JacobBanghart/clickdeck/hardware/driver-bench/netlist.txt

# driver-bench netlist (generated by gen_pcb.py; UNTESTED)

3V3: J1.7 R6.2 R7.2
AVDD1: C5.1 C6.1 U1.17 U1.2 U1.22 U1.23
CP1: C4.1 U1.6
EN1: J1.5 R5.1 U1.18 U1.19 U1.20 U1.24
EN2: J1.9 R8.1 U2.1 U2.2 U2.24 U2.3
FLT1: J1.6 R6.1 U1.1
FLT2: J1.8 R7.1 U2.20
GND: C1.2 C11.2 C12.2 C2.2 C3.2 C5.2 C6.2 C7.2 C8.2 C9.2 J1.1 J1.10 J4.2 R2.2 R3.2 R4.2 R5.2 R8.2 U1.16 U1.21 U1.25 U1.9 U2.12 U2.15 U2.25 U2.8
OUT1A: J2.1 U1.10
OUT1B: J2.2 U1.11
OUT1C: J2.3 U1.12
OUT2A: J3.3 U2.9
OUT2B: J3.2 U2.10
OUT2C: J3.1 U2.11
PWM_A: J1.2 R2.1 U1.15 U2.4
PWM_B: J1.3 R3.1 U1.14 U2.5
PWM_C: J1.4 R4.1 U1.13 U2.6
V3P3_2: C11.1 U2.18
VCP2: C10.1 U2.14
VM: C1.1 C10.2 C12.1 C2.1 C3.1 C4.2 C7.1 C8.1 C9.1 J4.1 U1.7 U1.8 U2.13 U2.16 U2.7

Not connected: U1.3 U1.4 U1.5 (SOC, SOB, SOA: current-sense outputs, unused), U2.17 U2.19 U2.21 U2.22 U2.23 (NC)
