JacobBanghart/clickdeck/docs/plan.md

# Plan

## Goals

**Final device**
- At least 20 keys, each showing its own image under a clear cap.
- Keys use **micro switches** (mouse/controller-style click), not rubber domes.
- At least 5 knobs, each with a display area right next to it.
- Knobs: **clicky vs. smooth switchable in software** (hard requirement).
  Adjustable detent count/strength and end stops are nice-to-have.
  Full force feedback is not required.
- **USB only.** Must not show up as a monitor.
- **Works standalone:** set up once in a web configurator, everything
  stored on the device. Optional host software for live integrations
  (Linux first).
- Knobs also **press to click**, like Stream Deck dials.
- An optional **touch band** under the knob displays for taps and swipes
  (an add-on, off by default since D24).
- Simple to build: case printable at home (256 mm bed), one JLC order.
  Cost isn't a design driver (a single build costs more than a Stream
  Deck + XL; [cost.md](cost.md)), but the numbers stay honest.
- **Cost target (owner, locked 2026-10-19, D24):** the full version
  (5 haptic knobs, 21 keys, display) at **$250 retail at 100 units**, plus
  shipping and taxes. Easy cuts applied: the DRV8311H driver, the touch
  band off by default, and for a 100-unit run factory-direct motors,
  owner-printed resin caps and bulk cables and hardware. At 100 units it
  comes out at ~$165–215 per device before one-time costs, so $250 holds
  near zero margin only if the one-time costs aren't spread over those 100
  ([cost.md](cost.md), "Path to $250").

**Explicitly not wanted**
- Hall-effect switches.
- Huge SmartKnob-sized knobs; aim for something closer to the MX Master
  MagSpeed wheel in size.

**Design constraints (owner, locked 2026-10-18; design review D8, D19–D21)**
- **Keys travel straight.** Caps move straight up and down, guided by the
  plate. No pivots, hinges or rockers on the keys, in this or any future
  revision. The knob press hinge (D10) is separate and not affected.
- **One shared display.** All key images and knob display areas come from
  the single shared LCD (Waveshare 7B). No separate small screens per key,
  and no screen inside or on top of a knob. The knob display areas stay
  above the knobs on the shared panel (`KNOB_WIN` in `cad/params.py`). More
  keys would need a bigger single panel, not more screens.
- **Core haptics first.** The knob feel is the focus: clicky detents,
  smooth, a set number of clicks, end stops, a tick at a preset. Attention
  nudges and haptic notifications are an optional firmware feature, off by
  default, in a separate module so a build can leave it out.
- **Its own look.** The face shape, stand, key and knob styling and
  branding stay clickdeck's own. Comparisons with the Stream Deck + XL are
  fine; the case and stand aren't modeled to look like it.

**Knobs are modules in slots (owner, locked 2026-10-19; D23, with D22)**
- The case keeps five knob positions as **slots**. Each takes a **haptic
  module** (motor, driver, sensor, press switch: software clicky and
  smooth), a **lite module** (an EC11-size push encoder, detented or smooth
  as ordered, D22) or a **blank** cover, flush with the plate.
- The first build has two haptic modules and three blanks; knobs get added
  later. Swap from the top with the case closed: pull the cap, undo two
  screws, lift the module out, drop the new one in. Unplug USB first (no
  hot-plugging).
- The old knob board becomes the **backplane**: RP2350B, connectors and one
  slot connector (18 pogo pins) per slot. Modules have no MCU; one firmware
  reads each slot's type at power-up, and the configurator shows haptic
  settings only for haptic slots and hides empty ones.
- Both module types put the knob top where the haptic knob was, checked by
  `cad/assembly.py --check` with every slot haptic, every slot lite and the
  default build. Modules: [knob-module.md](knob-module.md); pinout:
  [wiring.md](wiring.md); costs (base + per module): [cost.md](cost.md);
  parts: [bom.md](bom.md).

## Architecture

```
 PC: web configurator (browser, setup) · optional daemon (live integrations) · or nothing
   │  single USB-C cable, into the back wall
   ▼
 USB board: USB 2.0 hub (CH334F), reads the port's current offer (CC pins)
   ├── USB ──► backplane: RP2350B (USB device 1)
   │             ├── USB HID (keyboard + media) + WebUSB data channel → keymap, macros, knob settings
   │             ├── optional 1-wire link ──► display board GPIO6 (page, wake)
   │             ├── 5 knob slots (pogo pins): haptic module (MT6701 + driver + press switch),
   │             │     lite module (push encoder) or blank
   │             ├── 21-key matrix (frame PCB, switches only)
   │             └┄┄ I²C ┄┄► touch band (optional add-on, under the top plate)
   └── USB ──► ESP32-S3 + 7" display board (USB device 2; bought: Waveshare ESP32-S3-LCD-7B, 1024×600)
                 ├── WebUSB data channel → pages, images, display settings (~0.5 MB/s)
                 └── drives the LCD   → all key images + knob display areas
```

The host sees two USB devices behind a hub; the software pairs them
([protocol.md](protocol.md)). Inside the case every link is a bought cable
plugged into a connector JLC fits: no soldering or crimping
([wiring.md](wiring.md)).

### Software: web configurator, optional daemon
VIA-style: a **web configurator** (a static page using WebUSB, WebHID and
Web Serial; Chromium browsers only) is the main tool. It sets the key
layout and pages, HID shortcuts and macros, knob feel, images and
brightness, and updates the firmware of both chips. Everything is stored
on the device, so clickdeck works on any computer with no software
installed.

A small optional **host daemon** (`clickdeckd`) adds live integrations:
changing images, showing app state (mic muted, volume), running scripts.
OpenDeck or Companion Satellite thin clients are possible later, on top of
it. Details: [configurator.md](configurator.md).

Linux needs a udev rule (`uaccess`) so the browser can open the devices.

### Why a bulk channel for images
HID on full-speed USB is limited to ~64 KB/s (64-byte reports, one 120×120
key image ≈ 0.5 s), so WebHID is too slow. Each chip has a vendor bulk
interface that the browser reaches through WebUSB. Plan on about 0.5 MB/s
(Espressif's figure for its USB stack): one raw key takes ~85 ms, a raw
full page ~1.8 s. So RLE/JPEG is the default, not an option. Also: upload
icons once and reference them by CRC; redraw only the parts of the screen
that changed. Target: a full page in under 300 ms.

### Keys: images under clear caps
One LCD panel under a **frame-shaped PCB** (square window cut out per key).
A clear resin cap sits in each window; a tab on the cap presses a micro
switch mounted on the PCB strip between windows.

The frame PCB must not rest on the glass, and the glass must not be the
cap's stop (design review B1–B3, decision D8):
- **More frame support:** 14 M2 screws hold the frame PCB: 5 pan-head
  along the back and left edges (off the glass) and 9 countersunk, flush
  with the PCB's underside, over the glass (4 between the knob windows, 3
  on the right margin, 2 at strip crossings x = ±33 mm between key rows 2
  and 3).
- **Cap down-stop:** caps and frame PCB sit 0.8 mm above the glass
  (`GLASS_GAP`; the image sits ~0.6 mm deeper than with the old 0.2 mm).
  Rails under each cap's side lips and lugs at its back corners stop on the
  frame PCB after 0.5 mm of travel, past the B3U's worst-case 0.35 mm. 0.1
  and 0.2 mm shim washers tune the stack. `cad/keystack.py` checks that the
  worst cap drop (0.51 mm, with the guide below) plus the frame's flex (0.046 mm/N worst, down
  from 4.2 mm/N) leaves at least 0.1 mm to the glass at a 3 N press.
- **Cap guide (B3):** caps move straight up and down, guided by the plate.
  The plate's key hole continues down as a skirt around each cap, cut away
  where the lips, tab, lugs and switches pass, to 0.2 mm above the frame
  PCB. The fit is 0.05 mm per side (printed PETG plate, SLA caps). Tune it
  with the fit coupon via `HOLE_COMP`. Over 5.1 mm this lets the cap tilt up
  to 1.17°. That tilt is guide slop, not a feature. The down-stop keeps the
  cap off the glass: worst drop 0.51 mm, 0.29 mm to spare. `assembly.py
  --check` fails if that margin is under 0.1 mm, if a stop foot misses the
  PCB, or if a skirt side is missing. If off-center presses don't click
  cleanly on the prototype, use SLA resin guide inserts (~0.6°) or the
  second switch.
- **Second switch:** the prototype frame PCB has a second switch footprint
  per key. The off-center click test decides whether the full build needs two
  switches per key.

Laser-cut acrylic caps are out:
sheet tolerance alone is larger than the key stack's budget. The cap has
0.2 mm of vertical free play; an optional foam or silicone ring on the flange stops
rattle. Caps come in one standard clear finish for now; revisit the look
once real caps are in hand.

```
      ┌──────────────┐  ← clear cap (the image shows through it)
   ┌──┤              ├──┐  ← tab reaches past the window edge
 ══╧══╧══            ══╧══  ← PCB with a window cut out per key
  [sw]                      ← micro switch under the tab
 ───────────────────────────  ← one LCD panel
```

Knobs sit just past the panel edge; each knob's "display" is an area of
the same panel. There are no other screens (D19).

Full build target: Waveshare **ESP32-S3-LCD-7B** (non-touch, SKU 31727,
$33.99), 7" 1024×600 RGB panel with **adjustable backlight**. Chosen over
the original ESP32-S3-LCD-7 (800×480): same price and pinout, but the
original's backlight is on/off only (CH422G expander pin) without a wire
mod. Layout (from the CAD model): **7×3 = 21 keys at 22 mm pitch** (146 px
pitch; about 120×120 px visible under each cap) plus a ~20 mm strip below the keys for the 5 knob displays.
(5×4 at 30 mm doesn't fit: the panel's active area is only ~86 mm tall.)

The display board only draws the screen; it needs none of its free pins.
Keys, knobs and touch go to the RP2350B, which has its own USB connection
through the hub. 1024×600 is more work for the ESP32-S3 than 800×480; fine
for mostly static key images, but test full-screen redraw speed early.

Switches: **Omron B3U-1000P** (3.0 × 2.5 mm SMD tactile). The strip
between keys is 3.6 mm, so 13 mm mouse switches don't fit.

### Knobs
Small brushless gimbal motor + magnetic angle sensor + low-voltage driver,
run with the SimpleFOC library. Software modes (the core feel): clicky
(detent count/strength), smooth (free or light drag), a set number of
clicks, end stops, a tick at a preset. Haptic behavior follows documented
open-source behavior: SimpleFOC's motor control and SmartKnob's detent and
end-stop profiles ([lessons.md](lessons.md)). Attention nudges and haptic
notifications are an optional firmware module, off by default (D20).
Driver must work from USB 5 V: the **DRV8311H** (3–20 V, D24), with the
TMC6300 (2–11 V) as the fallback. **Not** the SimpleFOC Mini / DRV8313,
which needs 8–30 V. Rejected for D24: the STSPIN233 (99-week lead time),
the DRV8316 (cost) and a discrete bridge (part count, no protection). The
SS6343M (LeadPower, 3–16 V, $0.43) is a cheaper candidate tested on the
driver bench board.

Firmware notes:
- Five FOC loops on one RP2350B are unproven. FOC runs on core 1 from RAM,
  targeting ≥ 2–5 kHz per motor; all drivers are initialized before any is
  enabled. The test kit times 1 real and 4 dummy loops first.
- The 2204 has 84 cogging steps per turn, which don't line up with 24 or 48
  detents. Each knob gets a cogging feed-forward table from calibration.
- On wake, the detent grid re-anchors at the current angle, so the knob
  doesn't snap.
- In free smooth mode the driver sleeps with its outputs in Hi-Z (3-PWM
  shorts the windings at zero torque, which drags) and wakes only for
  effects. The DRV8311H takes 1–3 ms to wake and draws 7–13 mA awake, so
  idle drivers sleep.

All five slots are run by the **RP2350B on the backplane** (D23). Each
haptic module's motor is driven with 3 PWM signals through its slot: the
DRV8311H in 3x PWM mode takes them directly (each INHx sets a half-bridge
high or low; the enable line holds nSLEEP and the INLx pins, so low means
asleep and Hi-Z). No inverter (D24; the TMC6300 needed 6 inputs and one).
Nobody is known to run the DRV8311 with SimpleFOC yet, so the test kit
checks it on the driver bench board. Details in [pcb.md](pcb.md) and
[knob-module.md](knob-module.md).

**Slots and modules (D23).** Each slot has an opening in the top plate,
29.2 × 34.1 mm, with printed dividers between the openings that stiffen the
plate's front strip and guide the modules. A module is a printed base (it
sets the pogo pins' working height and carries two key pins of different
sizes), the module PCB, the knob parts, and a printed cover whose bezel is
flush with the plate. Two countersunk M2 screws through the bezel go into
heat-set inserts in the tray's slot bosses. The slot connector is 18 SMD
pogo pins on the backplane (top side) pressing ENIG pads under the module,
so every board stays top-side only (D6). The module stack makes the case
3.1 mm taller; the knob tops stay 16 mm above the plate at the old XY.

**Press to click:** each haptic knob sits on a tongue cut into its module
PCB, held by two torsion necks near its back edge (the hinge). An arm on
the printed motor spacer reaches forward over the slot to a B3U switch on
the module's fixed front border (top side); pressing the knob tips the
tongue down and an M2×3 set screw in the arm presses the switch. A plain
8 × 1.6 mm FR-4 bending neck was likely several times too stiff (design
review H3, decision D10), so:
1. First a $0 test: saw the module's tongue into scrap FR-4 and load it on
   the kitchen scale.
2. Rev A's modules have the torsion necks and an adjustable **set-screw
   striker**, so each knob's press gap is set on the bench. The module is a
   small board of its own, so a softer neck (or a 1.0 mm board) is a cheap
   reorder.
3. If sideways force on the knob causes false clicks (the cap top is far
   above the hinge), the next revision moves to a parallel-guided flexure.
Lite modules use the encoder's own push switch.

**Module floorplan** (D16, D6): the driver, switch and motor header sit
on the module's fixed front border, off the tongue, so only sensor traces
cross a neck. Before ordering, floorplan the module and the backplane with
real footprints (RP2350B QFN-80, DRV8311H WQFN-24, the pad field).
Motor current is measured on the test kit at the bench supply and the USB
power meter. Every board is **top-side only** (D6), so JLC's cheaper
single-side assembly fits everything; the backplane still needs a
reverse-mount BOOTSEL switch.

### Power budget
One USB-C cable feeds the display board, its backlight and 5 motors. One
SmartKnob motor alone draws ~0.7–1 A peak at 5 V. But a motor only draws
real current while it's pushing back on a hand: an untouched knob sits at a
detent center and needs no torque. So the budget is about **one motor's
worth (about 0.8–1.5 A, set by the port; below)**, enforced by a firmware arbiter:

- **Wake on movement.** All angle sensors stay on (10–14 mA each). A
  knob's driver wakes when it moves more than a fraction of a degree
  and goes back to sleep after 1–2 s without movement. The DRV8311H
  takes 1–3 ms to wake (D24); the wake-latency test checks it can't be
  felt.
- **Share the budget.** One active knob gets the full current limit; if
  two move at once, each gets half (they feel slightly weaker for that
  moment instead of browning out).
- **Time-limit end stops.** Pushing against a stop is the only sustained
  full-torque case; ease off if someone leans on it.
- **Calibrate knobs one at a time.** If a build includes the optional
  haptic-effects module, it queues its pulses so they never overlap.

**Power policy (D9): full haptics need a USB-C port that offers 1.5 A or
more, over a C-to-C cable.** The USB board reads the host port's
advertised USB-C current (CC pins, polled all the time) and the backplane
sets the motor budget from it:
- Default USB power (500 mA, or any A-to-C cable): haptics nearly off. The
  display, hub and logic already use about 0.5 A, so the motors only get
  faint detents and ticks. The configurator says why.
- 1.5 A port: about 0.8 A for the motors until real current is measured.
- 3 A port: 1.5 A (capped by the internal cable).

The motor budget is shared among the haptic slots, however many there are.
A device with only lite modules and blanks has no motors and draws about
0.46 A in all, so it runs on any USB port, including 500 mA ports and A-to-C
cables ([wiring.md](wiring.md)).

Until the backplane has read CC and been configured over USB, the motors
stay off and the backlight starts low. An optional USB-PD sink footprint
(CH224-class, not fitted by default) on the USB board could ask a PD
charger for 5 V at 3 A. A brownout guard on the 5 V input backs it all up
(it trips on a drop from idle, not a fixed 4.6 V). Details:
[wiring.md](wiring.md); see also [lessons.md](lessons.md) #2.

### Firmware updates and recovery
Both chips update from the web configurator over the single USB cable,
each over its own USB connection through the hub, through its ROM
bootloader: the ESP32-S3 with esptool-js over Web Serial, the RP2350B
through its UF2 bootloader over WebUSB (drag and drop of a UF2 works too).
No OTA slots and no custom bootloader: the ROM bootloader can't be
overwritten, so a failed update can always be retried. Trust is VIA-style
(D17): the browser's device picker is the confirmation, with no pinhole or
knob hold by default. An optional lock (stored on the device) brings back
a 3 s knob hold for reflashes and keymap changes. Bootloaders stay unlocked.

Three pinholes reach the display board's BOOT and RESET (back wall) and the
backplane's BOOTSEL (case floor, under the backplane's left end; lift the
slab off the stand to reach it). Settings live in flash that firmware updates don't
erase; holding the top-left key while plugging in resets them. Step by
step: [recovery.md](recovery.md).

### USB protocol
Follows lessons from Stream32's documented protocol
([lessons.md](lessons.md) #11–16): versioned hello with feature flags,
images stored by CRC so reconnects resend nothing, the device reports key
size in pixels, binary framing with RLE/JPEG, pages stored on the device
plus temporary live-state overlays, separate key-down/key-up events, and
keys that send their stored shortcuts with no host software.

**Offline pages and screen wake (D5):** the two chips only meet over USB
through the host. An optional one-wire link from the backplane to the
display board's GPIO6 connector carries page switches and activity, so
pages change and the screen blanks and wakes with no host. The backplane
has the footprint now; fitting the lead is optional. Without the link and
without a host, the display never idle-blanks
([protocol.md](protocol.md)).

### Touch band
**Optional add-on, off by default (D24).** The default build and BOM leave
it out (`TOUCH_BAR = False` in `cad/params.py`); the backplane keeps the SH
header's footprint, not fitted, and the knobs don't move, so a builder can
add the band later: order the band, fit the header (or order the backplane
with it) and reprint the top plate with `TOUCH_BAR = True` (it adds the
band's pocket). CI builds and checks that option too.

A thin capacitive sensor PCB under the top plate, just below the knob
displays: tap or swipe on the plate surface, like the + XL's touch strip.
(Touching the display glass itself doesn't work: it sits ~7 mm below the top
surface because of the key stack.) The knobs moved forward 4 mm to make the
band 11.2 mm tall (model). It sits close to the motor bells, so it has a
grounded guard trace, hatched ground on the bottom layer, and firmware
ignores touches for 300 ms around knob motion or a press
([pcb.md](pcb.md)). The realistic touch test (full-length band, motor
running, panel lit) happens on Rev A, the first build with a running motor
under a printed plate. If it fails, the band gets one revision with the
knobs further forward (D11), or is dropped (it's optional, D12).

Touch controller (D12): **AT42QT2120** (Microchip, SOIC-20; LCSC C614938,
$1.89, 69 in stock on 2026-10-17, not marked end-of-life; Farnell and RS also stock it). It replaces the
discontinued MPR121. Its built-in slider uses only 3 channels (too coarse
over ~155 mm), so all 12 channels run as separate electrodes and firmware
works out the position from their signal levels. The band is a
nice-to-have and unplugs; if the part can't be sourced, the band stays
out.

### Case material
The case holds about 2.3 W in a closed box, and the 7B is rated 0–65 °C.
Print it in **PETG** (not PLA), with 4 walls and ≥ 25% infill at the
bosses. Screws that get undone for service go into **M3 heat-set inserts**
(4.0 mm hole × 5.7 mm) in the top plate's 8 mm posts, with M3×6 machine
screws, not self-tapped plastic threads (D14). Log temperatures
for 2 h at full brightness on the first build.

## Stages (prototype: 2 keys on the 7B + a knob test stand, then Rev A)

Plan changed 2026-10-18 (D3) and 2026-10-19 (D23). Final parts are bought
early, tested on the bench and reused in the full build: the Waveshare 7B,
four 2204 motors from two sellers (2 for Rev A's haptic modules + 2 spare),
the magnets and the display cable. A throwaway test kit covers
the rest: a SparkFun TMC6300 breakout, an MT6701 breakout, a WeAct RP2350B
core board and a CH334F hub module (these two stay as the firmware dev
bench), a printed knob test stand, and two small custom PCBs: the rev C
2-key frame PCB on the real 7B and the driver bench board (D24: a DRV8311H
channel and an SS6343M channel). No custom knob module or controller board
before the full build. Parts and costs: [parts.md](parts.md), [cost.md](cost.md).

**Prototype (test kit):**

1. **Images over USB:** the display firmware (ESP-IDF) shows images sent
   over its WebUSB bulk interface on the 7B. Measure throughput and the
   flash-write glitch early.
2. **Two devices, one hub:** the 7B and the core board behind the CH334F
   module; the configurator pairs them. A stored keymap works with no
   software running; a "host" key changes its own image.
3. **Knob:** the 2204 on the printed test stand over the MT6701 breakout,
   driven by the SparkFun TMC6300 from the core board. SimpleFOC closed
   loop; clicky/smooth/stops set from the PC; current, standby and wake;
   1 real + 4 dummy FOC loops for timing. Then the same motor on the
   driver bench board: the DRV8311H (the haptic module's driver, 3 PWM +
   enable, as on the module) and the SS6343M, compared with the TMC6300
   ([prototype-tests.md](prototype-tests.md)).
4. **Keys:** the two top-left keys on the rev C frame PCB + clear caps on
   the 7B; adjust until a press anywhere on the key clicks cleanly, and
   compare one switch per key with two. Caps are JLC3DP clear resin
   prints. The top plate is printed (it carries the cap guides); the base
   plate is laser-cut acrylic.
5. **Hinge (free):** the module's tongue and torsion necks sawn into scrap
   FR-4, loaded on the kitchen scale (D10).
6. **Decide go/no-go:** if the knob and cap feel are both good → Rev A.
7. **Lite modules (D22):** no prototype of their own. An EC11 on a
   breadboard with the WeAct RP2350B bench checks the PIO quadrature
   reader, the press and the module-ID rows in the key matrix.

**Rev A (the full build):** the base and backplane, **2 haptic modules,
1 lite module** (so both module types are proven) and blanks in the other
slots. First test of everything the kit can't show: the hinge and press
feel, the motor mount fit, the slot connector and module swaps, slot
detection, our RP2350B, hub and CC sensing, the connectors and cables
(the touch band, optional since D24, is tested on the first build that
fits one)
([prototype-tests.md](prototype-tests.md)). Plan on one revision of
whichever board fails, and order only that board: the backplane and the
module boards are separate designs now ([cost.md](cost.md)).

Software: on the ESP32-S3, **ESP-IDF 5.x** (esp_lcd + esp_tinyusb; the
7B's RGB panel needs sdkconfig options a precompiled Arduino core can't
set: [protocol.md](protocol.md)). On the RP2350B, **arduino-pico +
SimpleFOC**, pinned. The web configurator in TypeScript; the optional
daemon with a Python library. Pin every version and build in CI.
