JacobBanghart/clickdeck/cad/out/summary.md

# Model summary (generated by cad/build.py)

## Full device
- Angled 42.0° on the stand: 178.4 wide x 130.7 deep x 125.3 mm tall (top plate at the back)
- Size: 178.4 x 146.5 mm footprint, 32.6 mm to the top plate (caps +1.5, knobs +16.0)
- Keys: 21 at 22.0 mm pitch, cap 18.0 mm
- Knob display window: 26.0 x 15.0 mm
- Z stack: glass 24.90, frame PCB 25.70-27.30, switch top 28.90, top plate 30.60-32.60, motor 14.70-27.80
- Key stack (D8): caps and frame PCB 0.80 mm above the glass, down-stop 0.50 mm; worst cap drop 0.51 mm (guide tilt + switch bottomed + down-stop), glass margin 0.29 mm; frame flex 0.046 mm/N (0.14 mm at 3 N)
- Cap guide (D8, B3): straight-line travel in the plate's key hole and skirt, 0.05 mm per side over 5.1 mm; max tilt 1.17° (guide slop, not a feature; the down-stop keeps the cap off the glass)
- Frame PCB screws: 5 pan-head off the glass, 9 countersunk (flush) over it
- Display board: 6.3 mm behind the backplane, 5.8 mm above the floor (Waveshare STEP depths)
- Internal cables (bought, plug-in): usb_display 100 mm, usb_knob_gh 100 mm, keys_ffc 100 mm, hy_link 50 mm; each haptic module coils its 300 mm motor lead in front of the bell (7.4 x 3.8 x 13 mm)
- Touch band: off (optional add-on, D24; CLICKDECK_TOUCH_BAR=1 builds it)
- Fit checks: OK

## Prototype
- Size: 183.7 x 115.6 mm footprint, 30.5 mm to the top plate (caps +1.5)
- Keys: 2 at 22.0 mm pitch, cap 18.0 mm
- Knob display window: 26.0 x 15.0 mm
- Z stack: glass 21.80, frame PCB 22.60-24.20, switch top 25.80, top plate 27.50-30.50, motor 11.60-24.70
- Key stack (D8): caps and frame PCB 0.80 mm above the glass, down-stop 0.50 mm; worst cap drop 0.49 mm (guide tilt + switch bottomed + down-stop), glass margin 0.31 mm; frame flex 0.009 mm/N (0.03 mm at 3 N)
- Cap guide (D8, B3): straight-line travel in the plate's key hole and skirt, 0.05 mm per side over 6.1 mm; max tilt 0.96° (guide slop, not a feature; the down-stop keeps the cap off the glass)
- Knob test stand (print): 40 x 40 x 26.6 mm to the motor seat; MT6701 breakout 16 mm wide (EST) on rails under the deck; motor screws M2×5 from below
- Standoffs: M3, plate to plate (corners) 24.5 mm, M3, base plate to the 7B's tabs 12.6 mm, M2, frame PCB to top plate 3.3 mm
- Fit checks: OK

## Knob slots (D23)
- 5 slots at the knob positions; each takes a haptic module, a lite module or a blank, dropped in from the top through a 29.2 x 34.1 mm opening and held by two M2 screws from the top
- Stack: backplane 4.00-5.60, module base 5.60-8.10, module PCB 8.10-9.70, motor 14.70-27.80
- Slot connector: 18 pogo pins per slot (C2988082, 3 mm, 1 mm stroke), compressed 0.50 mm (allowed 0.25-0.75)
- Module PCB 28.4 x 30.5 mm; retention screws M2x30 countersunk into M2 heat-set inserts in the slot bosses
- Lite: encoder body 9.70-16.20, shaft tip 31.20; 9.0 mm of shaft in the knob; pressed 0.5 mm: stem 0.50 mm above the bushing
- haptic, haptic, blank, blank, blank: knob tops within 0.00 mm of the haptic knob's position, covers/blanks flush within 0.00 mm
- haptic, haptic, haptic, haptic, haptic: knob tops within 0.00 mm of the haptic knob's position, covers/blanks flush within 0.00 mm
- lite, lite, lite, lite, lite: knob tops within 0.00 mm of the haptic knob's position, covers/blanks flush within 0.00 mm
- Fit checks: OK

## Stability (estimate)
- Estimated mass 647 g (stand 228 g, shelled); tips backward at 8.9 N on a top-row key (a firm press is ~3 N), or 3.3 N pulling the USB cable straight back. Rough densities, see cad/stability.py

## Printing (case parts)
- case_tray: 178 x 147 x 31 mm, fits a 256 mm bed
- top_plate: 178 x 147 x 30 mm, fits a 256 mm bed
- stand: 162 x 113 x 101 mm, fits a 256 mm bed

## JLC panel (estimate)
- Boards: frame PCB 169.5 x 95.6, backplane 161.1 x 57.8, USB board 81.0 x 33.3 mm; 282 cm² of bounding boxes
- Panel: ~215 x 155 mm = 334 cm² (2 mm gaps, 5 mm rails on two edges)
- Assumption: JLC's large-size fee counts the assembled area, 2 panels for one build = 668 cm² against 650 cm² (5 assembled for a group buy = 1669 cm²)
- Module boards (D23), own designs: haptic 28.4 x 30.5 mm, lite 28.4 x 30.5 mm
- WARNING: JLC panel area 668 cm² for one build is over the 650 cm² large-size threshold (~$57 fee) (accepted)
