JacobBanghart/clickdeck/cad/out/angle_compare.png

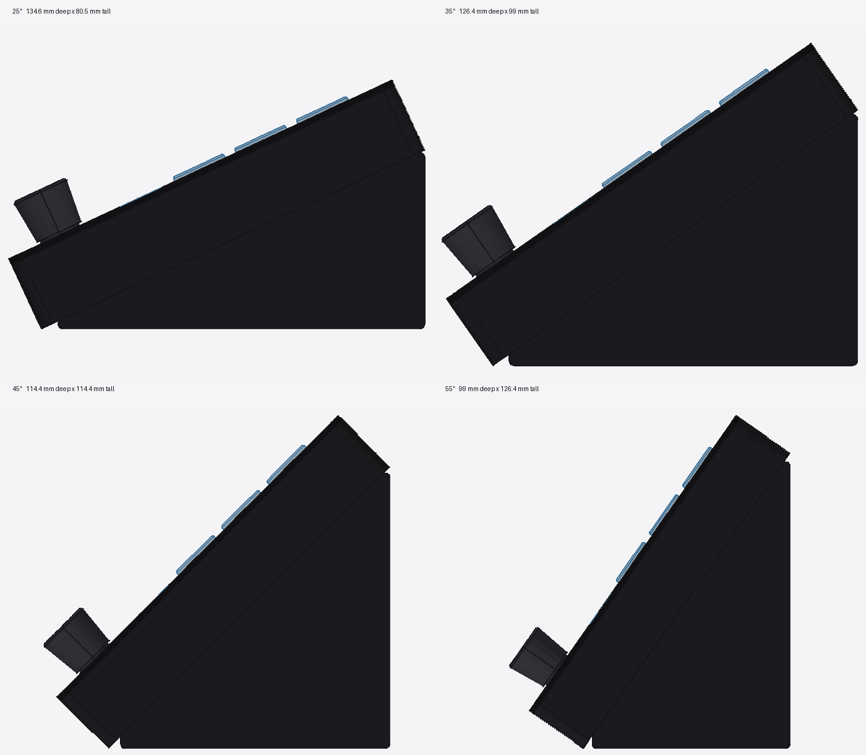
cad/out/angle_compare.png
