JacobBanghart/clickdeck/cad/out/freecad_front.png

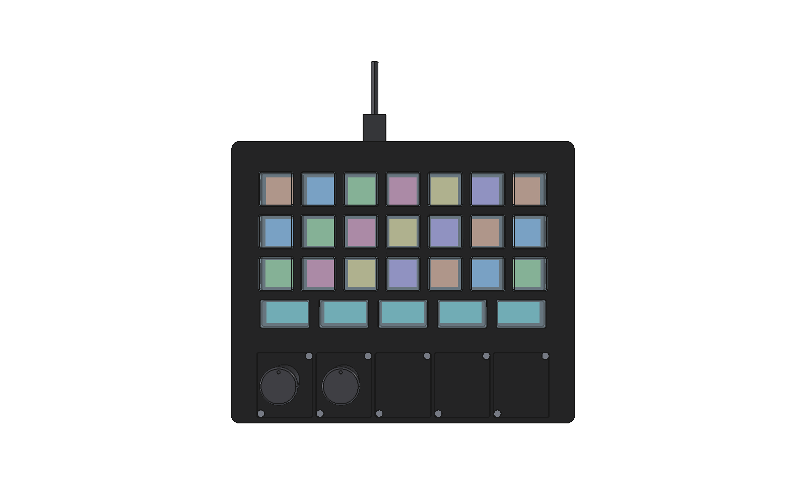
cad/out/freecad_front.png
