JacobBanghart/clickdeck/cad/out/freecad_side.png

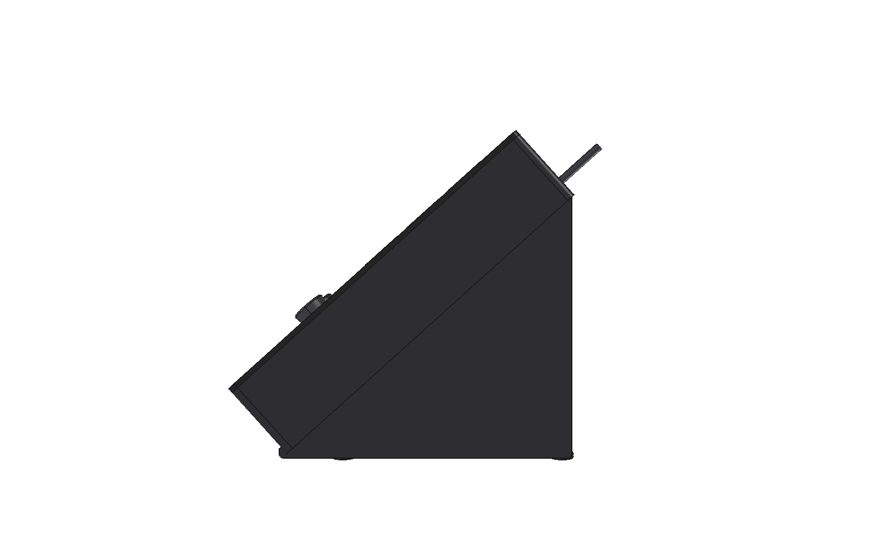
cad/out/freecad_side.png
