JacobBanghart/clickdeck/cad/out/full_face.png

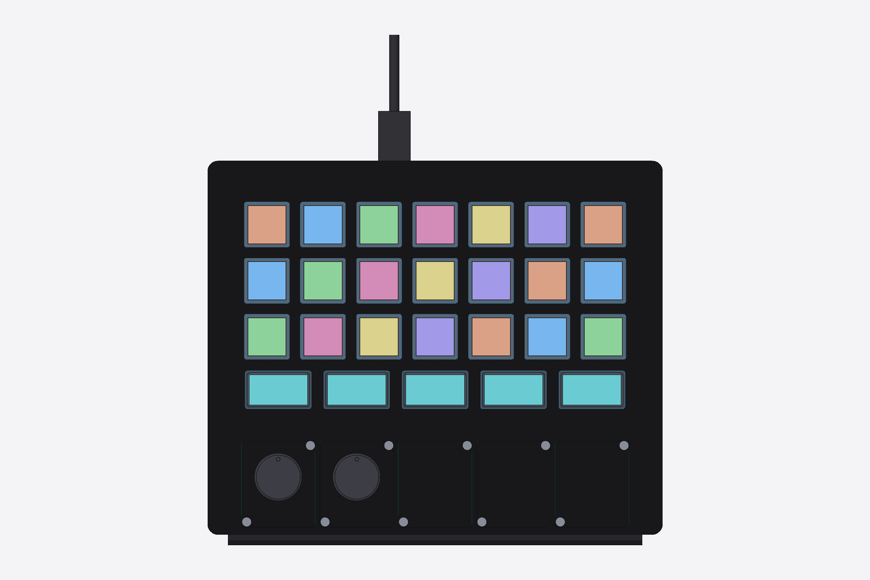
cad/out/full_face.png
