JacobBanghart/clickdeck/cad/out/full_iso.png

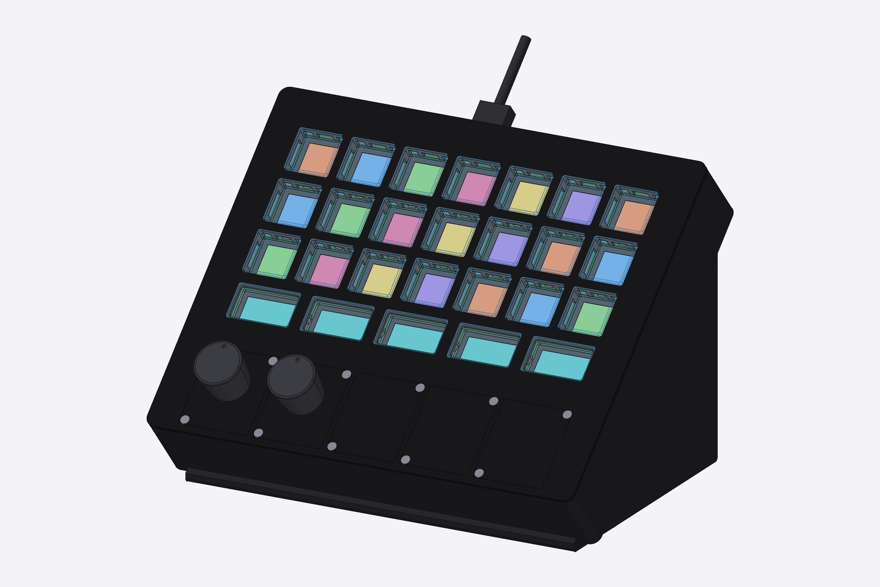
cad/out/full_iso.png
