JacobBanghart/clickdeck/cad/out/full_side.png

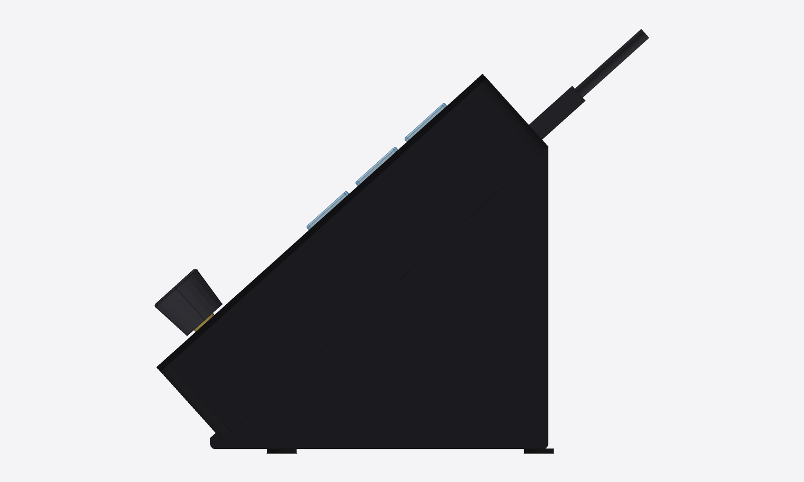
cad/out/full_side.png
