JacobBanghart/clickdeck/cad/out/proto_iso.png

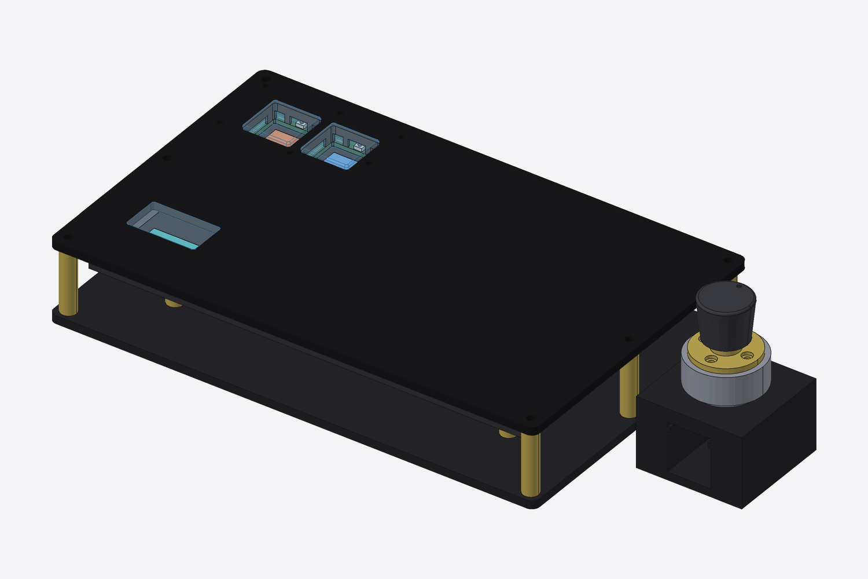
cad/out/proto_iso.png
