JacobBanghart/clickdeck/docs/bom.md

# Bill of materials

> [!CAUTION]
> Generated by `cad/assembly.py` from the CAD model; nothing has been built or
> ordered. **(V)** marks parts to verify before ordering. LCSC numbers were looked up
> on 2026-10-17 (encoders, pogo pins and the module header 2026-10-19); stock moves, so
> check each one in JLC's parts library when ordering.

Knobs are modules in slots (D23). This list has two parts: the **base device** (display,
keys, case, backplane, USB board, cables: no knobs) and what **each knob module or
blank** adds. Every slot takes a haptic module, a lite module or a blank. The touch band
is an optional add-on, off by default (D24): its board, chip and cable aren't in this list (`TOUCH_BAR = True` in params.py adds them; the backplane keeps the SH header's footprint).
The model's default build is the owner's first: haptic, haptic, blank, blank, blank.

The builder solders and crimps nothing: JLC fits every board-mounted part, and every
cable is bought ready-made. Screws, cable types and lengths come from the model, so they
match [assembly.md](assembly.md). Totals: [cost.md](cost.md).

## Base device

### Order 1: JLC (PCBs, assembly, prints)

#### PCBs

| Qty | Part | Spec | Source / LCSC # | ~Price | Used in |
|---|---|---|---|---|---|
| 1 panel | PCBs: backplane, frame PCB, USB board, panelized | 2-layer FR-4 1.6 mm, ENIG (owner decision: flat pads for the 0.4 mm QFNs and the pogo contacts); outlines from `cad/out/*.dxf`. Every part on one side of each board (D6), so JLC's Economic (single-side) assembly can take them. The frame PCB has countersunk M2 holes (JLC countersink option, V: fee) so its screws sit flush over the glass. JLC makes 5 panels and assembles at least 2 | JLCPCB | $45–70 for 5 panels (ENIG, 3-design fee); fees in cost.md | all boards |

#### Parts JLC fits (per device)

| Qty | Part | Spec | Source / LCSC # | ~Price | Used in |
|---|---|---|---|---|---|
| 1 | RP2350B, stepping A4 (erratum E9 fixed) | QFN-80 microcontroller, 48 GPIO, native USB | [C42415655](https://www.lcsc.com/product-detail/C42415655.html) (stepping A4 per LCSC; 4,720 in stock, 2026-10-17) (V: A4 marking) | ~$1.3 | backplane |
| 1 | RP2350B support parts | 16 MB QSPI flash W25Q128JVSIQ [C97521](https://www.lcsc.com/product-detail/C97521.html); 12 MHz crystal X322512MSB4SI [C9002](https://www.lcsc.com/product-detail/C9002.html) (basic, 20 pF load, 80 Ω ESR) with 2 × 33 pF C0G [C1562](https://www.lcsc.com/product-detail/C1562.html) and the 1 kΩ series resistor. Raspberry Pi's reference is the ABM8-272-T3 [C20625731](https://www.lcsc.com/product-detail/C20625731.html) (10 pF, 50 Ω) with 2 × 15 pF; same 3225 footprint, so it's the fallback if Rev A's crystal start-up test fails. 3.3 µH SMPS inductor AOTA-B201610S3R3-101-T [C42411119](https://www.lcsc.com/product-detail/C42411119.html) (3 in JLC stock, pre-order minimum 32, 2026-10-17). No stocked substitute: Raspberry Pi requires a polarity-marked, shielded 3.3 µH ±20%, DCR ≤ 250 mΩ, Isat ≥ 1.5 A, and only this part is marked. 3.3 V regulator AMS1117-3.3 [C6186](https://www.lcsc.com/product-detail/C6186.html) (basic, 1 A) with 22 µF on its output. Flash, crystal, caps and regulator are basic parts | JLC (V: inductor stock on order day) | $3–4 | backplane |
| 1 | GH 8-pin header, HCTL HC-GH-8PWT | 1.25 mm GH, side entry, latching (USB link). Clone of JST SM08B-GHS-TB: 13.25 mm wide with solder tabs, 4.25 mm tall, mates with JST GH plugs | [C3011950](https://www.lcsc.com/product-detail/C3011950.html) (1,726 in JLC stock, $0.18, 2026-10-17; the JST part [C265111](https://www.lcsc.com/product-detail/C265111.html) has 0) (V: pad drawing on layout day) | ~$0.2 | backplane |
| 1 | FFC/FPC connector, 12-pin 1.0 mm, flip-lock ZIF, right angle | e.g. XUNPU FPC-1.0FX-12PWCR-H20 (V: contact side, height) | [C19269355](https://www.lcsc.com/product-detail/C19269355.html) | ~$0.2 | backplane |
| — (footprint, DNP) | JST BM06B-SRSS-TB | 6-pin SH header, top entry (touch cable). Not fitted by default (D24): the footprint stays so a touch band can be added later (fit the header, or order the backplane with it) | [C160392](https://www.lcsc.com/product-detail/C160392.html) | — | backplane |
| 1 (optional) | HY2.0 3-pin header, 2.0 mm, SMD side entry | GPIO6 link to the 7B's J8 (D5); the footprint is always on the board, fit it if you use the link | LCSC (V: part not chosen) | ~$0.1 | backplane |
| 1 | BOOTSEL button | reverse-mount SMD tact switch (plunger through the board, pressed through the floor pinhole). If none is found: a plain SMD tact switch on the bottom side, the board's only bottom-side part | LCSC (V: part not chosen) | ~$0.1 | backplane |
| 3 | SRV05-4-P-T7 ESD arrays | 4 lines each, SOT-23-6, pin 5 to 3V3. Three on the 10 key-matrix lines at the ZIF, one on SDA/SCL at the SH header (DNP with the header); series resistors on every line | [C85364](https://www.lcsc.com/product-detail/C85364.html) (preferred extended: no loading fee; 36,942 in JLC stock, 2026-10-17) | ~$0.6 | backplane |
| 90 | Pogo pin, SMD, BAT WIRELESS BWCD-L3W2.0H1.0 | slot connectors (D23): 18 per slot, upright on the top side (D6), 3 mm tall, 2 mm barrel, 1 mm stroke, ~1 N, 1.5 A, 10,000 cycles, gold-plated brass. They press the ENIG pads under each module; pinout in wiring.md | [C2988082](https://www.lcsc.com/product-detail/C2988082.html) (32,763 in JLC stock, $0.0596 at 50–149, 2026-10-19; extended) (V: drawing, force at 0.5 mm) | ~$5.4 | backplane |
| 1 set | Backplane passives | ~470 µF bulk on the motor rail; decoupling; 1 kΩ BOOTSEL resistor at the MCU end; pull-downs on the five SSI data lines and the two ID rows; one 10 kΩ pull-up on the shared nFAULT line (the slots' contact C6, D24); CC sense filters; I²C pull-ups for the touch band (the drivers' pull-downs sit on the haptic modules) | JLC basic parts | $2–4 | backplane |
| 1 | TPS259470ARPWR eFuse (motor rail) | soft-start switch for the motor rail only (to the slots' VMOT pins), enabled by firmware after reading CC and only with a haptic module fitted. Same part as the USB board's two VBUS switches: true reverse blocking, current limit set by RILM (0.5–6 A), slew rate set by a dVdt cap | [C3662799](https://www.lcsc.com/product-detail/C3662799.html) (4,468 in JLC stock, $1.29, 2026-10-17) | ~$1.3 | backplane |
| 21 | B3U-1000P | key switches (buy spares and sort by feel) | [C231329](https://www.lcsc.com/product-detail/C231329.html) | ~$3 | frame PCB |
| 21 | 1N4148W | SOD-123 matrix diodes (each module adds 2: press and ID) | JLC basic part | ~$0.5 | frame PCB |
| 1 | FFC/FPC connector, 12-pin 1.0 mm, flip-lock ZIF | same as on the backplane | [C19269355](https://www.lcsc.com/product-detail/C19269355.html) | ~$0.2 | frame PCB |
| 1 | WCH CH334F | 4-port USB 2.0 hub, QFN-24; PSELF strapped low (bus-powered), 0 Ω option to flip | [C5187527](https://www.lcsc.com/product-detail/C5187527.html) (8,489 in stock, $0.63, 2026-10-17) | ~$0.6 | USB board |
| 1 | 12 MHz crystal, 3225 | CH334F XI/XO (its load caps are built in); plus a 0 Ω link footprint that can ground XI for crystal-free mode. Same part as the RP2350B's crystal | [C9002](https://www.lcsc.com/product-detail/C9002.html) (basic) | ~$0.1 | USB board |
| 1 | USB-C receptacle, 16-pin, mid-mount (sinks 1.6 mm into the board) | external port; HCTL HC-TYPE-C-16P-CB1.6 (V: get the drawing; slot and pad depth in the outline are from the model, shell legs unverified) | [C2894902](https://www.lcsc.com/product-detail/C2894902.html); fallback top-mount TYPE-C-31-M-12 [C165948](https://www.lcsc.com/product-detail/C165948.html) | ~$0.2 | USB board |
| 1 | USB-C receptacle, 16-pin, TYPE-C-31-M-12 | internal port to the display board; SMD signals, 4 through-hole shell legs | [C165948](https://www.lcsc.com/product-detail/C165948.html) | ~$0.2 | USB board |
| 1 | GH 8-pin header, HCTL HC-GH-8PWT | USB link to the backplane; same as on the backplane | [C3011950](https://www.lcsc.com/product-detail/C3011950.html) | ~$0.2 | USB board |
| 2 | TPS259470ARPWR eFuses (VBUS) | one per downstream VBUS branch: display port (RILM 3.32 kΩ, ~1 A) and backplane (RILM ~1.87 kΩ, ~1.8 A). Back-to-back FETs block reverse current while on, so the 7B can't back-feed the PC. Enable delayed by an RC. QFN-10 2 × 2 mm, 0.45 mm pitch | [C3662799](https://www.lcsc.com/product-detail/C3662799.html) (one type for all three switches) | ~$2.6 | USB board |
| 1 | SRV05-4-P-T7 | USB ESD, external port, at the socket: D+, D−, CC1, CC2 on its four lines, pin 5 to VBUS. 3.5 pF typ (5 pF max) per line; the datasheet lists USB 2.0, so it suits the 480 Mbit/s pair. Same SOT-23-6 footprint as the USBLC6-2SC6 [C7519](https://www.lcsc.com/product-detail/C7519.html), but its four lines are separate pins (no flow-through), so route each line to its own pad | [C85364](https://www.lcsc.com/product-detail/C85364.html) (preferred extended: no loading fee) | ~$0.2 | USB board |
| 1 (optional, not fitted) | USB-PD sink, CH224-class (e.g. CH224K) | D9: footprint beside the external port on its CC lines, to ask a PD charger for 5 V / 3 A. Not fitted by default; the policy is a 1.5 A+ C-to-C port | LCSC (V: part and stock) | ~$0.5 + extended fee | USB board |
| 1 | VBUS TVS | 5–5.5 V standoff, clamping below 6 V (the CH334F sits straight on VBUS; check its absolute max) | LCSC (V: not chosen) | ~$0.1 | USB board |
| 1 set | USB board passives | 5.1 kΩ CC pull-downs ×2, 56 kΩ CC pull-ups ×2 (display port), 10 kΩ CC sense resistors ×2 (+ 10–22 kΩ at the knob end), 2 × 22 µF 25 V X5R at the input (CL21A226MAQNNNE C45783, basic; keep a 22–47 µF polymer footprint, fitted only if the hot-plug test rings), RC delay on the switch enables, RILM and dVdt parts, 22 µF on the CH334F's VDD33, decoupling | JLC basic parts | ~$1 | USB board |

JLC's assembly minimum is 2 boards, so you pay for the parts on a spare set too
(see [cost.md](cost.md)). JLC charges a setup fee once for the panel, plus a fee per
"extended" part type: 13 types with the parts above (list and fees in cost.md).
Prices are LCSC's at the quantity for 2 boards, 2026-10-17.

#### 3D prints

| Qty | Part | Spec | Source / LCSC # | ~Price | Used in |
|---|---|---|---|---|---|
| 21 | Clear key caps | `cad/out/key_cap_clear_resin.stl`, clear resin (SLA), one standard clear finish (D15; revisit after seeing it). The rails and lugs underneath are the down-stop | JLC3DP | $20–40 | Build the top plate |
| 5 | Knob-window covers | `cad/out/knob_window.stl`, clear resin (SLA), same order as the caps; sit on a ledge in the top plate | JLC3DP | $3–6 | Build the top plate |
| 1 | Case tray | `cad/out/print_case_tray.stl`; the cable clips are part of it. PETG, 4 walls, ≥25% infill | home printer or JLC3DP | $4–6 / $20–40 | Print the case |
| 1 | Top plate | `cad/out/print_top_plate.stl` (exported face-down); PETG, 100% infill over the touch band, no CF/metal-filled filament; M3 heat-set inserts in its four posts | home printer or JLC3DP | $3–5 / $15–30 | Print the case |
| 1 | Stand | `cad/out/print_stand.stl` (a shell, open underneath, with ribs); PETG | home printer or JLC3DP (get a quote) | $2–4 / $10–25 | Put it on the stand |
| 2 | Plate props (tool) | `cad/out/print_plate_prop.stl`: hold the top plate 40 mm up while you plug its cables in | home printer | <$1 | Close the case |
| 1 | Fit coupon (optional) | `cad/out/print_fit_coupon.stl`: cap holes, magnet pocket and hub fit at three sizes; print it first and set `HOLE_COMP` in params.py | home printer | <$1 | Print the case |

### Order 2: AliExpress / Waveshare

#### Bought parts

| Qty | Part | Spec | Source / LCSC # | ~Price | Used in |
|---|---|---|---|---|---|
| 1 | Waveshare ESP32-S3-LCD-7B (non-touch, SKU 31727) | 7" 1024×600 display board. No battery on J3 | Waveshare | $34 | Mount the display |

#### Internal cables (ready-made, plug-in)

| Qty | Part | Spec | Source / LCSC # | ~Price | Used in |
|---|---|---|---|---|---|
| 1 | USB-C to USB-C | USB 2.0 (3 A), one 90° side-exit end + one straight end; **100 mm** (model route 98 mm) | AliExpress (search the spec) | $2–4 | Mount the display; plug in its USB cable |
| 1 | JST-GH 1.25 mm 8-pin | plugs both ends, pin 1 to pin 1 ("same direction"), 26 AWG; **100 mm** (model route 73 mm) | AliExpress (search the spec) | $1–2 (26 AWG) | Screw in the backplane; plug in the USB link |
| 1 | FFC | 12-pin, 1.0 mm pitch, contacts on opposite sides (type B); **100 mm** (model route 28 mm, 74 mm with the plate lifted) | AliExpress (search the spec) | $0.06 (LCSC [C80646](https://www.lcsc.com/product-detail/C80646.html), reverse) to $1 | Build the top plate (on the bench) |
| 1 | HY2.0 (2.0 mm) 3-pin | plugs both ends, pin 1 to pin 1 (optional); **50 mm** (model route 29 mm) | AliExpress (search the spec) | ~$0.5 (optional) | Mount the display; plug in its USB cable |

Search terms that find them: "USB C to USB C 90 degree 10cm" (pick a side-angle (left/right) plug for the display end, not up/down); "JST GH 1.25 8 pin double head cable 10cm" (same direction, 26 AWG); the FFC is LCSC C80646 (12-pin 1.0 mm, 100 mm, reverse/opposite side), or "FFC 12 pin 1.0mm 100mm" type B; optional: "HY2.0 3 pin double head 5cm" (GPIO6 link).

#### Hardware

| Qty | Part | Spec | Source / LCSC # | ~Price | Used in |
|---|---|---|---|---|---|
| 4 | M3x16 screw | machine | hardware kit | ~$1 (pack of 50) | Mount the display; plug in its USB cable |
| 12 | M2x5 screw | thread-forming | hardware kit | ~$1 (pack of 50) | Build the top plate (on the bench), Screw in the backplane; plug in the USB link |
| 9 | M2x5 screw | countersunk thread-forming | hardware kit | ~$1 (pack of 50) | Build the top plate (on the bench) |
| 4 | M3x6 screw | machine | hardware kit | ~$1 (pack of 50) | Close the case |
| 4 | M2x6 screw | thread-forming | hardware kit | ~$1 (pack of 50) | Screw in the USB board |
| 4 | Magnets 8 × 1.5 mm | tray | AliExpress | ~$1 | Print the case; fit magnets, feet and inserts |
| 4 | Magnets 8 × 3 mm | stand | AliExpress | ~$1 | Put it on the stand |
| 6 | Rubber feet 10 × 1.5 mm | self-adhesive | AliExpress | ~$1 | Print the case; fit magnets, feet and inserts, Put it on the stand |
| 4 | M3 heat-set inserts, 4 mm hole × 5.7 mm | top plate posts (e.g. Ruthex RX-M3x5.7 or CNC Kitchen M3 short) | AliExpress / Amazon | ~$1 | Print the case; fit magnets, feet and inserts |
| 10 | M2 heat-set inserts, 3.2 mm hole × 4 mm | slot bosses: the modules' and blanks' screws go into these (D23; V: an M2 × 4 mm insert, ~3.5 mm outside) | AliExpress | ~$1 | Print the case; fit magnets, feet and inserts |
| 1 set | M2 shim washers, 0.1 and 0.2 mm | between the frame PCB and its bosses, to tune the key stack | AliExpress | ~$1 | Build the top plate (on the bench) |
| — | Epoxy | magnets | any | ~$3 | Print the case; fit magnets, feet and inserts |
| — (optional) | Thin foam or silicone ring | on each key cap's flange, against rattle | any | ~$1 | Build the top plate (on the bench) |

### Not in the kit

| Qty | Part | Spec | Source / LCSC # | ~Price | Used in |
|---|---|---|---|---|---|
| 1 | USB-C to USB-C cable (to the computer) | USB 2.0 is enough; a C-to-C cable lets the device read the port's 1.5 A / 3 A offer. An A-to-C cable works, with weaker haptics (500 mA). Plug overmold ≤ 12.5 × 6.5 mm to seat in the back-wall opening | any | $3–8 | Plug it in |

## Knob modules and blanks (per slot)

One of these per slot. Each module type is its own small JLC design (5 PCBs made, at
least 2 assembled), ordered with the base or later; the motors, magnets and screws come
with order 2. Modules have no MCU: the backplane runs every slot (D23).

### Haptic module

| Qty | Part | Spec | Source / LCSC # | ~Price | Used in |
|---|---|---|---|---|---|
| 1 | Module PCB, haptic | 28.4 × 30.5 mm, 2-layer 1.6 mm, ENIG; `cad/out/module_haptic_pcb_outline.dxf`. The motor's tongue hangs on two torsion necks (the hinge, D10); 18 ENIG pads underneath meet the slot's pogo pins (pads aren't parts, so every part is on top, D6). Its own JLC design: 5 made, at least 2 assembled (cost.md) | JLCPCB | $4–8 of a $20–40 order | Build the knob modules |
| 1 | DRV8311HRRWR (TI) | 3-phase motor driver, 3–20 V, 5 A peak, hardware variant, WQFN-24 3 × 3 mm 0.4 mm, on the fixed front border (D16). 3x PWM (MODE to AVDD); nSLEEP and INLA/B/C on NSTDBY (D24). Fallback: TMC6300-LA-T [C5274455](https://www.lcsc.com/product-detail/C5274455.html) (other footprint: a module respin) | [C5218862](https://www.lcsc.com/product-detail/C5218862.html) (7,399 in JLC stock, $0.95 at 500, 2026-10-19; extended) | ~$1.0–1.4 | Build the knob modules |
| 1 | MT6701CT-STD | magnetic angle sensor, SSI, SOP-8 (not the QT: that's a 3×3 QFN-16), on the tongue under the magnet | [C3003196](https://www.lcsc.com/product-detail/C3003196.html) (V: JLC stock) | ~$1.6 | Build the knob modules |
| 1 | B3U-1000P | knob press switch on the front border (the spacer's arm presses it) | [C231329](https://www.lcsc.com/product-detail/C231329.html) | ~$0.2 | Build the knob modules |
| 2 | 1N4148W | press switch and module-ID diodes (key matrix; wiring.md) | JLC basic part | ~$0.02 | Build the knob modules |
| 1 | Pin header 1×3, 2.54 mm, vertical SMD (HX PZ2.54-1x3P TP-YQ) | motor plug, upright on the front border; staggered SMD pins (D6) | [C41417360](https://www.lcsc.com/product-detail/C41417360.html) (47,856 in JLC stock, $0.039, 2026-10-19) (V: fits the motor's plug) | ~$0.04 | Build the knob modules |
| 1 set | Module passives | 2 × 22 µF 0805 25 V (C45783) and 100 nF on VM/VIN_AVDD; 100 nF CP to VM; 1 µF on AVDD; 100 nF on CSAREF (tied to AVDD); 10 kΩ pull-downs on NSTDBY and the three PWM nets (RP2350 erratum E9: they live with the driver, so a lite module's lines stay free); 10 kΩ CSN pull-up; decoupling. MODE and SLEW tied to AVDD, GAIN to GND, the current-sense outputs open | JLC basic parts | ~$0.3 | Build the knob modules |
| 1 | Module base | `cad/out/module_base.stl`: under the PCB, sets the pogo pins' 2.5 mm working height; two key pins (2 and 1.4 mm) underneath. PETG | home printer or JLC3DP | <$1 | Build the knob modules |
| 1 | Module cover | `cad/out/module_cover.stl`: bezel flush with the plate, four posts, front wall. PETG, black like the plate | home printer or JLC3DP | <$1 | Drop in the knob modules |
| 1 | Motor spacer ring | `cad/out/motor_spacer.stl`: sets the sensor gap, centers the magnet; the arm carries the press striker. PETG | home printer or JLC3DP | <$1 | Build the knob modules |
| 1 | Knob hub | `cad/out/knob_hub.stl`: D-flat column, flange screwed to the bell; PETG | home printer or JLC3DP | <$1 | Build the knob modules |
| 1 | Knob cap | `cad/out/knob.stl` (D-bore with crush ribs); PETG | home printer or JLC3DP | <$1 | Press on the knob caps |
| 1 | 2204 gimbal motor (Mitoot 2204 260KV or similar) | ~28 × 13 mm, hollow shaft; lead ~30 cm with a 3-pin 2.54 mm servo-style (Futaba/JR) plug per one listing (V: check plug and lead on arrival; measure base/bell hole patterns and thread depths against params.py) | AliExpress (two sellers); for a 100-unit run, factory-direct after samples (cost.md) | $8–12 ($5–9 landed at 100) | Build the knob modules |
| 1 | Diametric magnet 6 × 2.5 mm | for the MT6701 | AliExpress | ~$1 | Build the knob modules |
| 1 | M2×3 set screw | press striker, in the spacer's arm | hardware kit | ~$0.1 | Build the knob modules |
| — | Epoxy | the magnet | any | — | Build the knob modules |
| 4 | M2x8 screw | machine | hardware kit | ~$1 (pack of 50) | Build the knob modules (on the bench) |
| 4 | M2x3 screw | countersunk machine | hardware kit | ~$1 (pack of 50) | Build the knob modules (on the bench) |
| 2 | M2x30 screw | countersunk machine | hardware kit | ~$2 (pack of 20) | Drop in the knob modules and blanks; screw them down |

### Lite module

| Qty | Part | Spec | Source / LCSC # | ~Price | Used in |
|---|---|---|---|---|---|
| 1 | Module PCB, lite | 28.4 × 30.5 mm, 2-layer 1.6 mm, ENIG; `cad/out/module_lite_pcb_outline.dxf`: the haptic outline, pads and holes, no tongue. Its own JLC design: 5 made, at least 2 assembled | JLCPCB | $3–6 of a $15–30 order | Build the knob modules |
| 1 | Push encoder, Bourns PEC11R, vertical, 15 mm flatted 6 mm shaft, push switch | Pick one when ordering (D22): **detented** PEC11R-4215F-S0024 (24 detents, 24 pulses) or **smooth** PEC11R-4015F-S0024 (no detents, 24 pulses). Same body, shaft and footprint; the push switch is the knob press. Through-hole: JLC hand-solders it under Economic assembly (7 joints, ~$0.0173 per joint; V: on the quote). Leads trimmed to ≤ 1.2 mm (the backplane is 2.5 mm below). SMD option for the detented build only: Alps EC11J1525402 [C209762](https://www.lcsc.com/product-detail/C209762.html) (30 detents, 1,666 in JLC stock, $2.59 at 10, 2026-10-19; other footprint) | [C143790](https://www.lcsc.com/product-detail/C143790.html) detented (5,249 in stock, $2.00 at 10) / [C143789](https://www.lcsc.com/product-detail/C143789.html) smooth (3,748, $2.73 at 1), 2026-10-19 (V: body height, shaft length) | ~$2–3 | Build the knob modules |
| 2 | 1N4148W | push switch and module-ID diodes (key matrix) | JLC basic part | ~$0.02 | Build the knob modules |
| 1 set | Module passives (lite) | 10 kΩ pull-ups to 3V3 on A and B, then 10 kΩ in series (it also limits the current if a misread slot drives these lines as PWM) and 10 nF to GND (Bourns' filter) | JLC basic parts | ~$0.1 | Build the knob modules |
| 1 | Module base | `cad/out/module_base.stl`, the same as the haptic module's | home printer or JLC3DP | <$1 | Build the knob modules |
| 1 | Module cover | `cad/out/module_cover.stl`, the same as the haptic module's | home printer or JLC3DP | <$1 | Drop in the knob modules |
| 1 | Knob cap (lite) | `cad/out/knob_lite.stl`: the same cap with a stem through the cover's hub hole; D-bore with crush ribs that seats on the encoder's shaft tip; PETG | home printer or JLC3DP | <$1 | Press on the knob caps |
| 2 | M2x30 screw | countersunk machine | hardware kit | ~$2 (pack of 20) | Drop in the knob modules and blanks; screw them down |

### Blank cover

| Qty | Part | Spec | Source / LCSC # | ~Price | Used in |
|---|---|---|---|---|---|
| 1 | Blank cover | `cad/out/blank_cover.stl`: bezel flush with the plate, four posts down to the backplane, front wall. PETG | home printer or JLC3DP | <$1 | Drop in the knob modules |
| 2 | M2x30 screw | countersunk machine | hardware kit | ~$2 (pack of 20) | Drop in the knob modules and blanks; screw them down |

## Prototype parts from the model (D3)

The rest of the prototype list is in [parts.md](parts.md).

| Qty | Part | Spec | Source / LCSC # | ~Price | Used in |
|---|---|---|---|---|---|
| 1 | Prototype frame PCB, rev C | 58.3 × 30.7 mm, the full build's two top-left keys on the 7B; 4 B3U footprints (a second switch above each key for the D8 force test), 4 M2 holes off the glass, 2 countersunk over it, solder pads off the glass. `hardware/proto-frame/`. The only custom PCB before Rev A | JLCPCB (assembled) | $35–55 with shipping and duty (cost.md) | prototype |
| 2 + 2 | Key caps: one nub and two nubs | `cad/out/key_cap_clear_resin.stl` (one switch) and `cad/out/key_cap_two_nub_clear_resin.stl` (two switches), clear resin, one standard finish | JLC3DP | $4–8 | prototype |
| 1 | Knob test stand | `cad/out/print_knob_test_stand.stl`, 40 × 40 mm, 26.6 mm to the motor seat. The 2204 screws on with 4 × M2×5 from below; an MT6701 breakout (16 mm wide, EST: measure it) slides in on rails under the deck. With `knob.stl` and `knob_hub.stl` | JLC3DP (PETG or resin) | $3–8 | prototype |
| 1 | Prototype top plate | `cad/out/print_proto_top_plate.stl`, 3 mm, with the cap guide skirts (0.05 mm per side, D8). Tune the fit with the coupon via `HOLE_COMP` first | JLC3DP or home printer (PETG or resin) | $5–10 | prototype |
| 1 set | Standoffs (model lengths; round to stock, shim the rest) | M3, plate to plate (corners): **24.5 mm**; M3, base plate to the 7B's tabs: **12.6 mm**; M2, frame PCB to top plate: **3.3 mm** | hardware kit | ~$5 | prototype |

## Totals

Base device **~$320–505** with your own 3D printer, plus per module (US import duty
included; one build, module boards ordered with the base): haptic ~$42–57 each for two
(~$28–38 each for five), lite ~$26–33 each for two, blank ~$1. The owner's first build
(2 haptic + 3 blank) comes to **~$405–620**. Prices above are per part; the totals also
include JLC's PCB, setup and extended-part fees, the parts on the spare boards, shipping and
duty. Breakdown and the 5, 25 and 100 unit figures: [cost.md](cost.md).
