JacobBanghart/clickdeck/hardware/driver-bench/jlc/driver-bench-bom.csv

Comment | Designator | Footprint | LCSC
DRV8311HRRWR | U1 | Texas_RRW0024A_WQFN-24-1EP_3x3mm_P0.4mm_EP1.9x1.9mm | C5218862
22uF 25V | C1,C2,C7,C8,C12 | C_0805_2012Metric | C45783
100nF | C3,C4,C6,C9 | C_0603_1608Metric | C14663
1uF | C5,C10 | C_0603_1608Metric | C15849
SS6343M-QF-TP | U2 | QFN-24-1EP_3x4mm_P0.4mm_EP1.65x2.65mm | C5370899
4.7uF | C11 | C_0603_1608Metric | C19666
10k | R2,R3,R4,R5,R6,R7,R8 | R_0603_1608Metric | C25804
