JacobBanghart/clickdeck/hardware/proto-frame/jlc/proto-frame-bom.csv

Comment | Designator | Footprint | LCSC
B3U-1000P | SW1,SW2,SW3,SW4 | SW_SPST_B3U-1000P | C231329
