JacobBanghart/clickdeck/cad/out/clickdeck_full.step

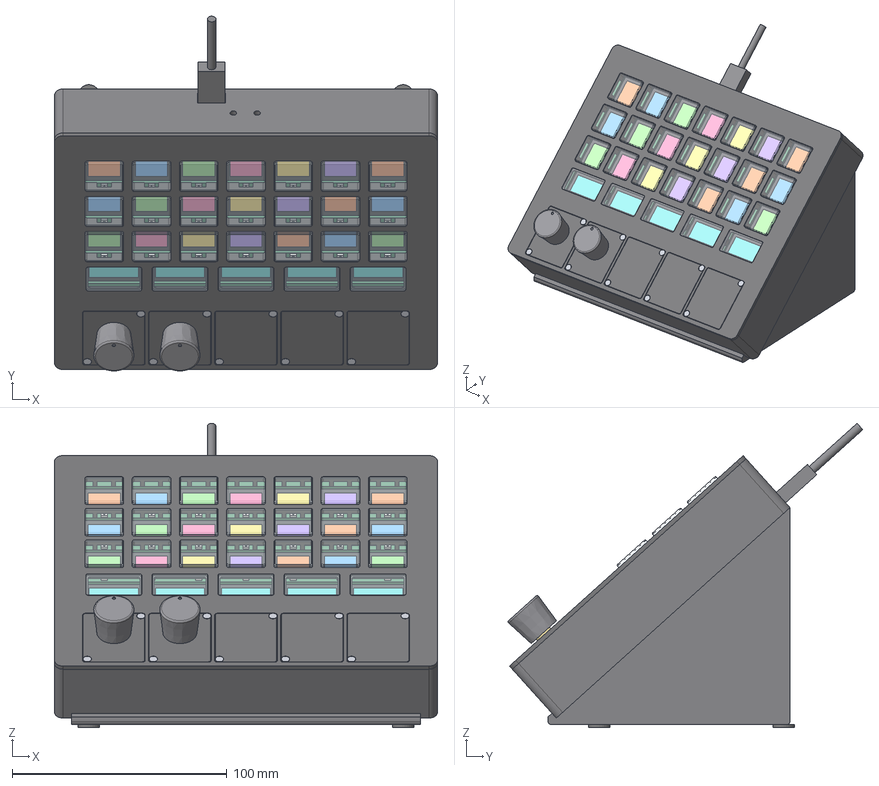
[picture p19: CAD file, 2026-10-19]
cad/out/clickdeck_full.step
178.4 x 165.2 x 141.8 mm
stand
case_tray
magnet_tray_0
magnet_tray_1
magnet_tray_2
magnet_tray_3
foot_front_0
foot_front_1
display_board_pcb
display_board_bosses
display_board_esp32s3
display_board_usb_c
display_board_connectors
display_board_buttons
panel7_module
panel7_active_area
panel7_image_0
panel7_image_1
panel7_image_2
panel7_image_3
panel7_image_4
panel7_image_5
panel7_image_6
panel7_image_7
panel7_image_8
panel7_image_9
panel7_image_10
panel7_image_11
panel7_image_12
panel7_image_13
panel7_image_14
panel7_image_15
panel7_image_16
panel7_image_17
panel7_image_18
panel7_image_19
panel7_image_20
panel7_knob_display_0
panel7_knob_display_1
panel7_knob_display_2
panel7_knob_display_3
panel7_knob_display_4
frame_pcb
switch_20 x 21
cap_20 x 21
top_plate
top_plate_insert_0
top_plate_insert_1
top_plate_insert_2
top_plate_insert_3
knob_window_0
knob_window_1
knob_window_2
knob_window_3
knob_window_4
backplane_pcb
backplane_rp2350b
backplane_pogo0
backplane_pogo1
backplane_pogo2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
