JacobBanghart/clickdeck/cad/out/full_usb_board_outline.dxf

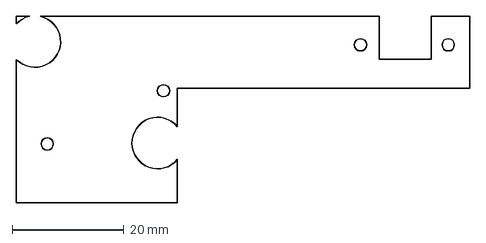
[picture p20: CAD file, 2026-10-19]
cad/out/full_usb_board_outline.dxf
81.0 x 33.3 mm
