JacobBanghart/clickdeck/cad/out/full_frame_pcb_outline.dxf

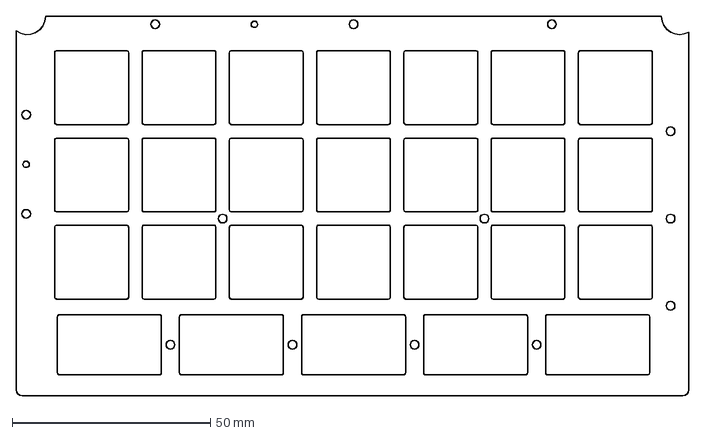
[picture p21: CAD file, 2026-10-19]
cad/out/full_frame_pcb_outline.dxf
169.5 x 95.6 mm
