JacobBanghart/clickdeck/cad/out/full_backplane_outline.dxf

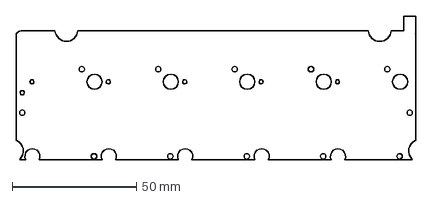
[picture p22: CAD file, 2026-10-19]
cad/out/full_backplane_outline.dxf
161.1 x 57.8 mm
