JacobBanghart/clickdeck/cad/out/full_top_plate.dxf

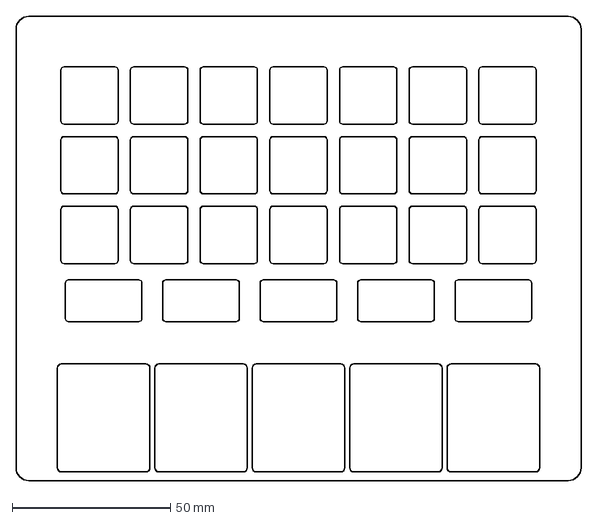
[picture p23: CAD file, 2026-10-19]
cad/out/full_top_plate.dxf
178.4 x 146.5 mm
