JacobBanghart/clickdeck/cad/out/full_touch_band_outline.dxf

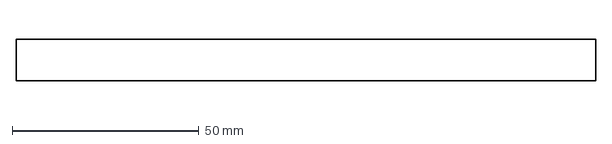
[picture p24: CAD file, 2026-10-19]
cad/out/full_touch_band_outline.dxf
155.3 x 11.2 mm
