JacobBanghart/clickdeck/cad/out/full_knob_board_lite_outline.dxf

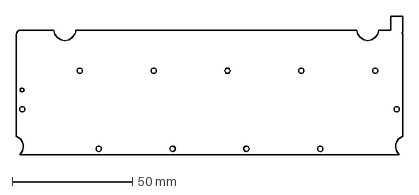
[picture p25: CAD file, 2026-10-19]
cad/out/full_knob_board_lite_outline.dxf
161.1 x 57.8 mm
