JacobBanghart/clickdeck/cad/out/module_lite_pcb_outline.dxf

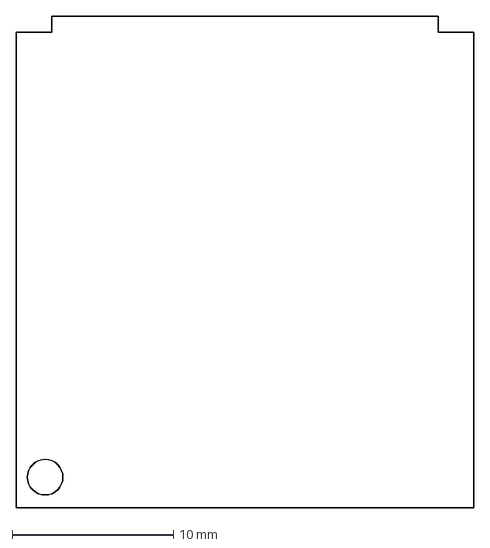
[picture p26: CAD file, 2026-10-19]
cad/out/module_lite_pcb_outline.dxf
28.4 x 30.5 mm
