JacobBanghart/clickdeck/cad/out/print_top_plate.stl

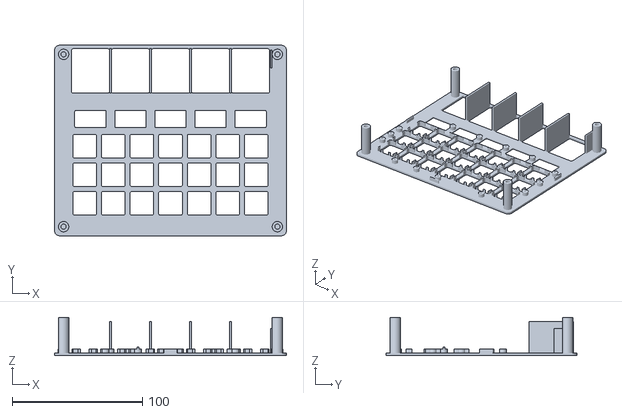
[picture p27: CAD file, 2026-10-19]
cad/out/print_top_plate.stl
178.4 x 146.5 x 29.6
