JacobBanghart/clickdeck/cad/out/clickdeck_proto.step

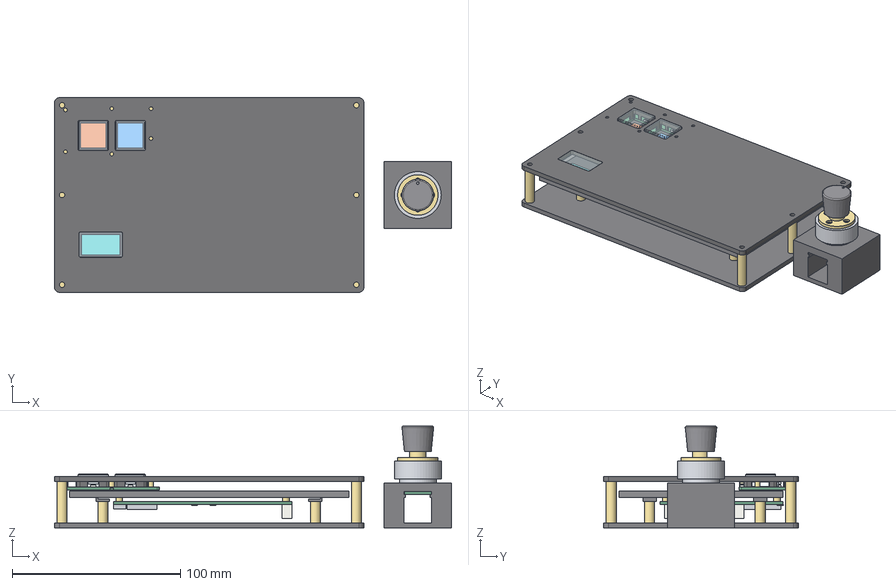
[picture p28: CAD file, 2026-10-19]
cad/out/clickdeck_proto.step
235.7 x 115.6 x 60.5 mm
base_plate_acrylic
standoff_m3_0
standoff_m3_1
standoff_m3_2
standoff_m3_3
standoff_m3_4
standoff_m3_5
panel_standoff_m3_0
panel_standoff_m3_1
panel_standoff_m3_2
panel_standoff_m3_3
display_board_pcb
display_board_bosses
display_board_esp32s3
display_board_usb_c
display_board_connectors
display_board_buttons
panel7_module
panel7_active_area
panel7_image_0
panel7_image_1
panel7_knob_display_0
frame_pcb
switch_3 x 4
cap_1 x 2
frame_standoff_m2_0
frame_standoff_m2_1
frame_standoff_m2_2
frame_standoff_m2_3
frame_standoff_m2_4
frame_standoff_m2_5
top_plate_proto
knob_window_0
test_stand
test_stand_mt6701_breakout
test_stand_mt6701
test_stand_magnet
test_stand_motor_2204
test_stand_hub
test_stand_knob
