JacobBanghart/clickdeck/cad/out/knob_modules.step

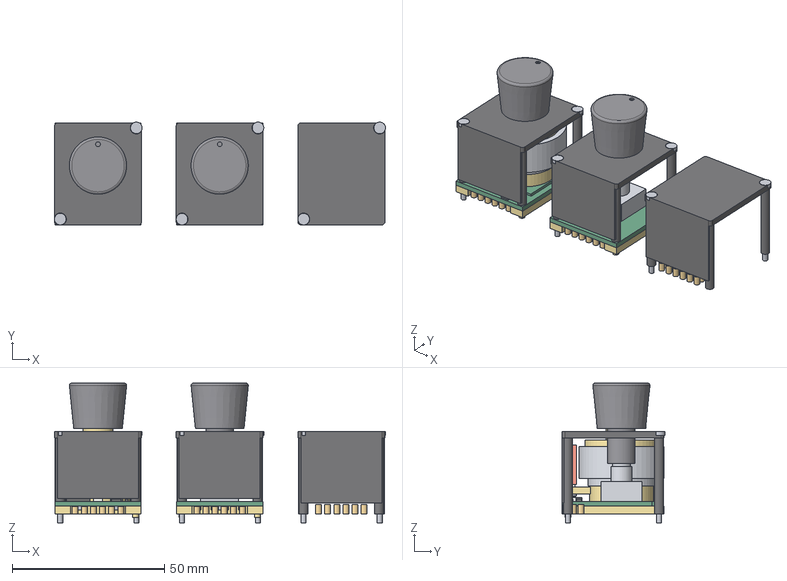
[picture p29: CAD file, 2026-10-19]
cad/out/knob_modules.step
108.8 x 33.8 x 46.0 mm
haptic_backplane_pogo0
haptic_knob0_pcb
haptic_knob0_base
haptic_knob0_mt6701
haptic_knob0_chips
haptic_knob0_press_switch
haptic_knob0_striker
haptic_knob0_spacer
haptic_knob0_magnet
haptic_knob0_motor_2204
haptic_knob0_header
haptic_cable_motor0_coil
haptic_knob0_hub
haptic_knob0_knob
haptic_knob0_cover
haptic_knob0_motor_plug
haptic_screw_motor0_0
haptic_screw_motor0_1
haptic_screw_motor0_2
haptic_screw_motor0_3
haptic_screw_hub0_0
haptic_screw_hub0_1
haptic_screw_hub0_2
haptic_screw_hub0_3
haptic_screw_slot0_0
haptic_screw_slot0_3
lite_backplane_pogo0
lite_knob0_pcb
lite_knob0_base
lite_knob0_encoder
lite_knob0_knob
lite_knob0_cover
lite_screw_slot0_0
lite_screw_slot0_3
blank_backplane_pogo2
blank_knob2_blank
blank_screw_slot2_0
blank_screw_slot2_3
