JacobBanghart/clickdeck/cad/out/proto_base_plate_3mm_acrylic.dxf

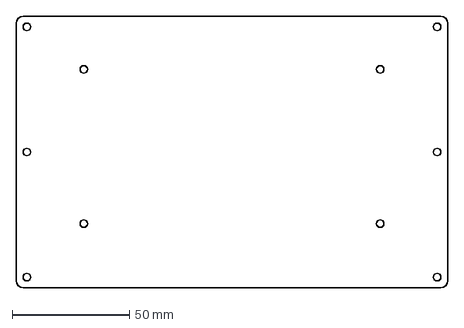
[picture p30: CAD file, 2026-10-19]
cad/out/proto_base_plate_3mm_acrylic.dxf
183.7 x 115.6 mm
