JacobBanghart/clickdeck/cad/out/module_haptic_pcb_outline.dxf

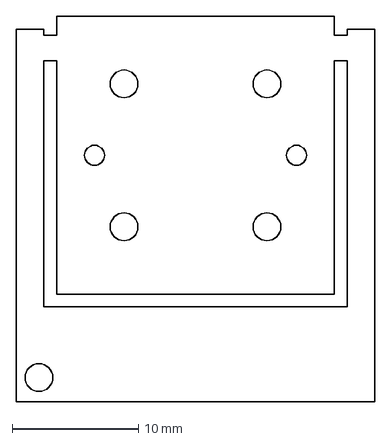
[picture p31: CAD file, 2026-10-19]
cad/out/module_haptic_pcb_outline.dxf
28.4 x 30.5 mm
