JacobBanghart/clickdeck/cad/out/proto_frame_pcb_outline.dxf

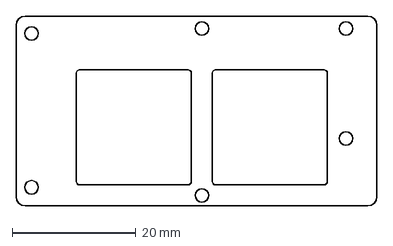
[picture p32: CAD file, 2026-10-19]
cad/out/proto_frame_pcb_outline.dxf
58.3 x 30.7 mm
