JacobBanghart/clickdeck/cad/out/key_cutaway.step

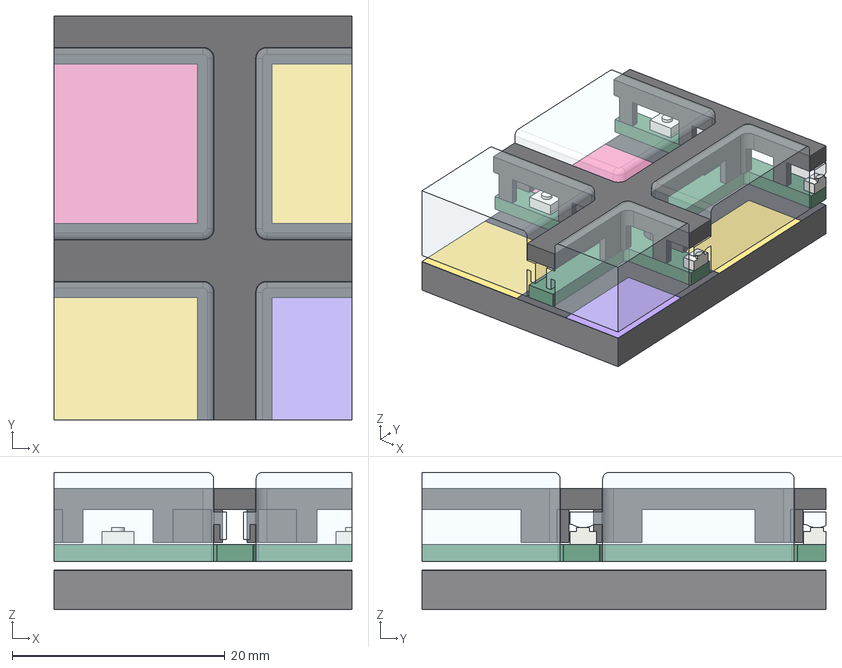
[picture p33: CAD file, 2026-10-19]
cad/out/key_cutaway.step
28.0 x 38.0 x 12.9 mm
panel7_module
panel7_active_area
panel7_image_9
panel7_image_10
panel7_image_16
panel7_image_17
frame_pcb
switch_2
switch_3
switch_9
switch_10
cap_2
cap_3
cap_9
cap_10
cap_16
cap_17
top_plate
