JacobBanghart/clickdeck/cad/out/knob_lite.stl

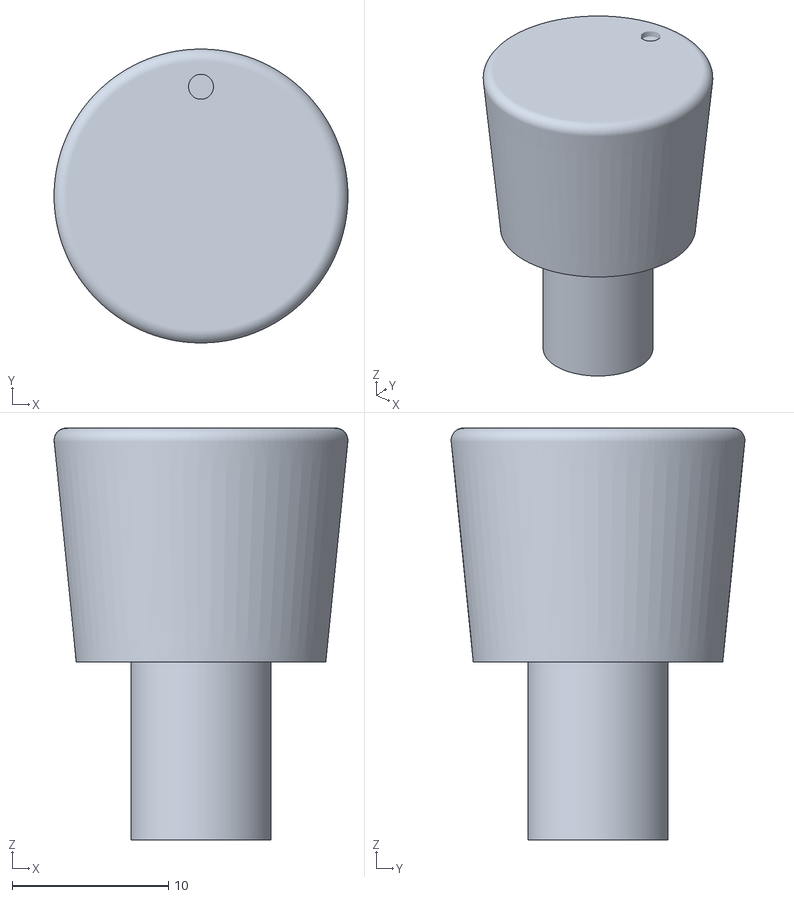
[picture p34: CAD file, 2026-10-19]
cad/out/knob_lite.stl
18.8 x 18.8 x 26.4
