JacobBanghart/clickdeck/cad/out/blank_cover.stl

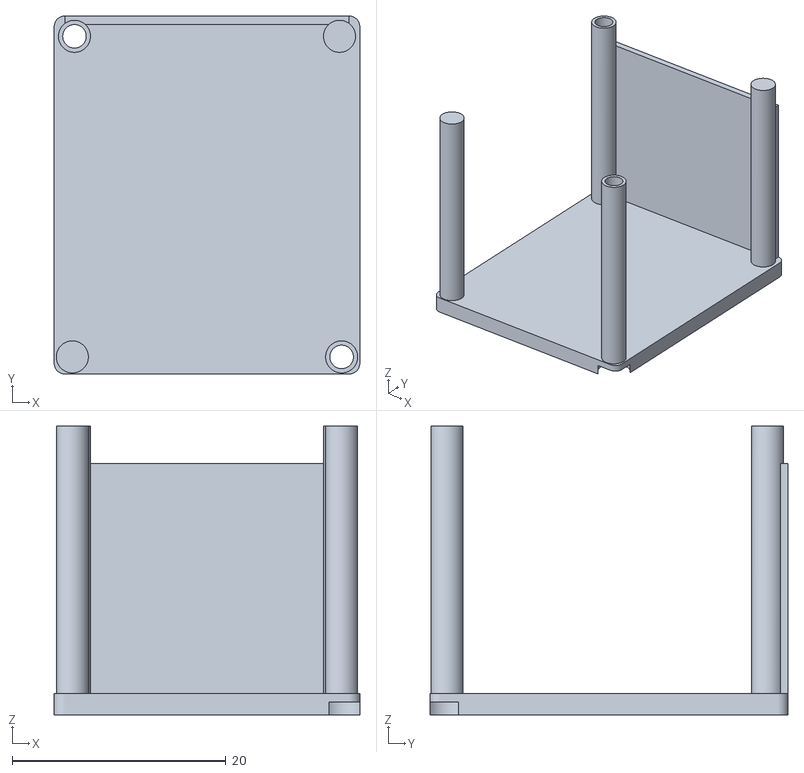
[picture p35: CAD file, 2026-10-19]
cad/out/blank_cover.stl
28.6 x 33.5 x 27.0
