JacobBanghart/clickdeck/cad/out/knob_hub.stl

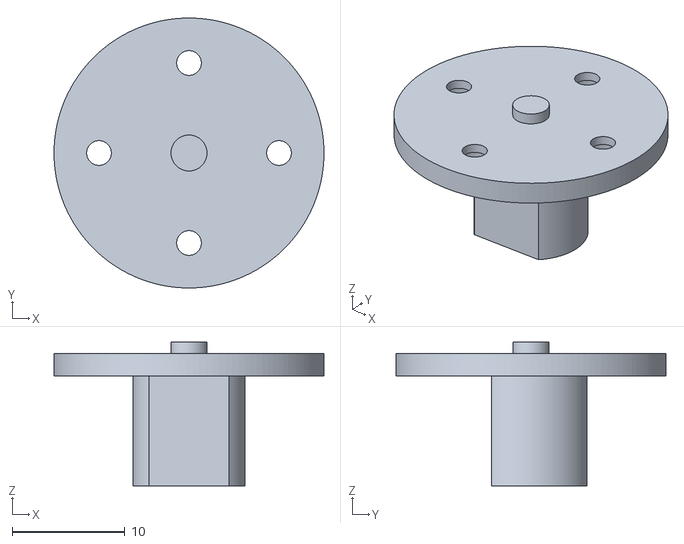
[picture p36: CAD file, 2026-10-19]
cad/out/knob_hub.stl
24.0 x 24.0 x 12.8
