JacobBanghart/clickdeck/cad/out/motor_spacer.stl

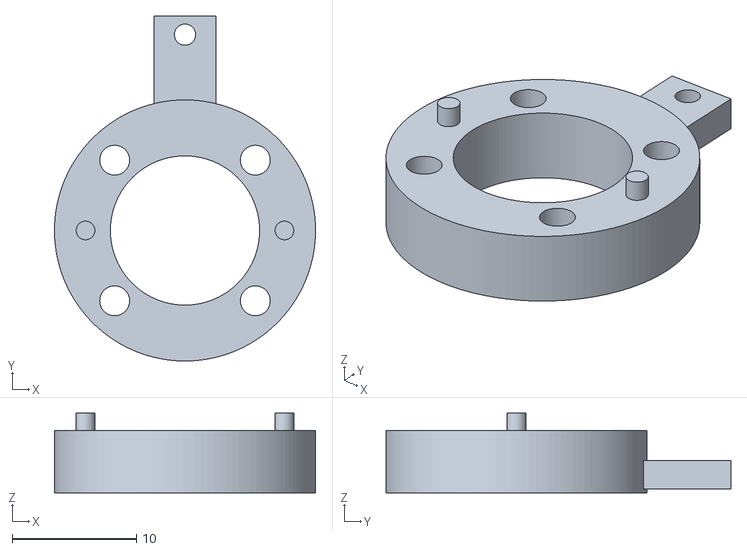
[picture p37: CAD file, 2026-10-19]
cad/out/motor_spacer.stl
21.0 x 27.7 x 6.40
