JacobBanghart/clickdeck/cad/out/key_cap_clear_resin.stl

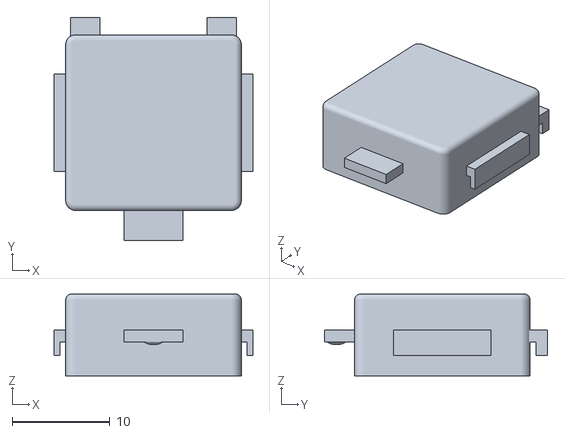
[picture p38: CAD file, 2026-10-19]
cad/out/key_cap_clear_resin.stl
20.4 x 22.9 x 8.40
