JacobBanghart/clickdeck/cad/out/print_case_tray.stl

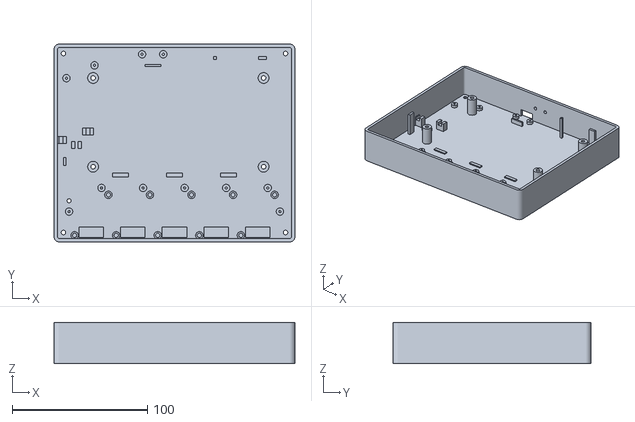
[picture p39: CAD file, 2026-10-19]
cad/out/print_case_tray.stl
178.4 x 146.5 x 30.6
