JacobBanghart/clickdeck/cad/out/module_cover.stl

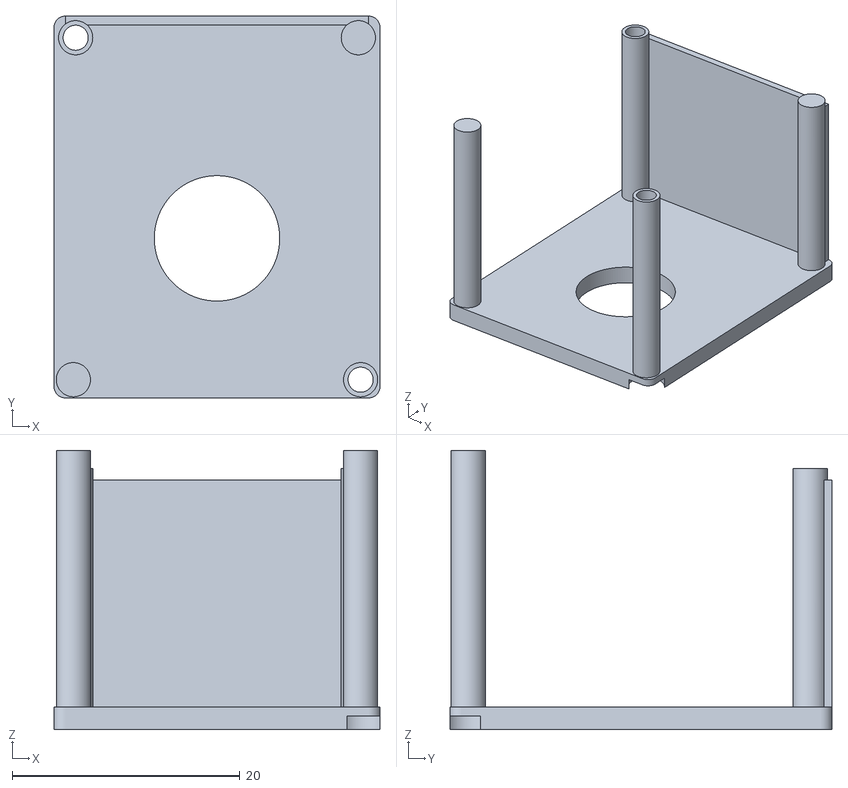
[picture p40: CAD file, 2026-10-19]
cad/out/module_cover.stl
28.6 x 33.5 x 24.5
