JacobBanghart/clickdeck/cad/out/module_base.stl

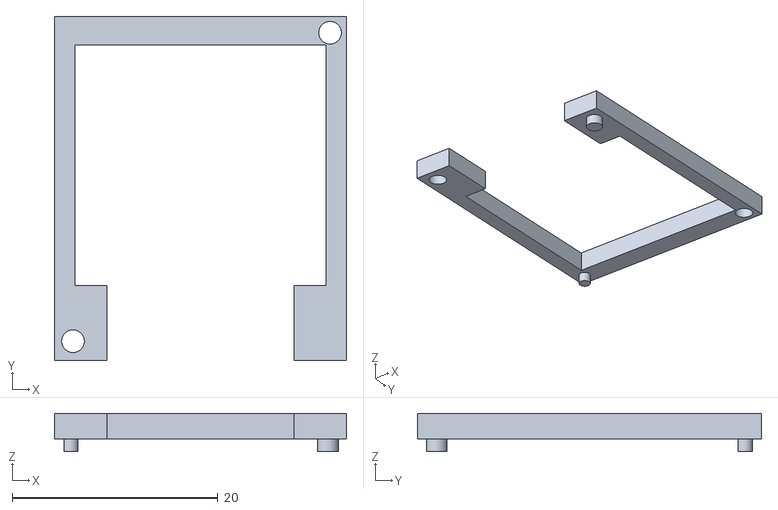
[picture p41: CAD file, 2026-10-19]
cad/out/module_base.stl
28.4 x 33.5 x 3.70
