JacobBanghart/clickdeck/cad/out/print_proto_top_plate.stl

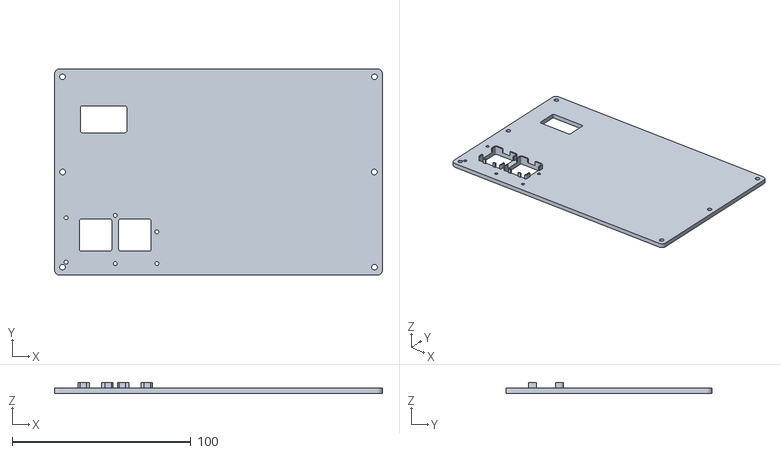
[picture p42: CAD file, 2026-10-19]
cad/out/print_proto_top_plate.stl
183.7 x 115.6 x 6.10
