JacobBanghart/clickdeck/cad/out/print_fit_coupon.stl

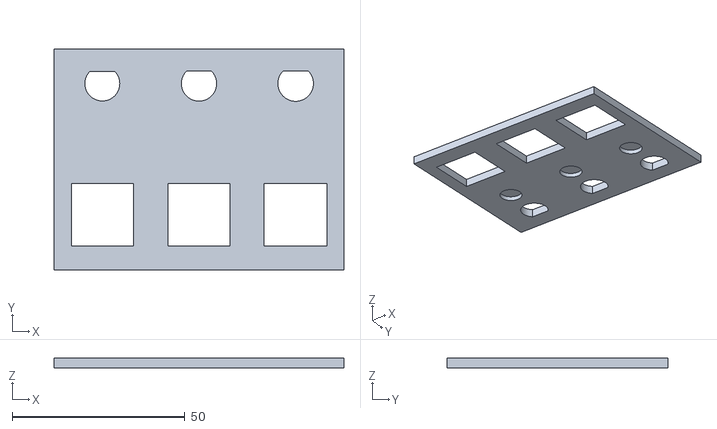
[picture p43: CAD file, 2026-10-19]
cad/out/print_fit_coupon.stl
84.0 x 64.0 x 3.00
