JacobBanghart/clickdeck/cad/out/knob.stl

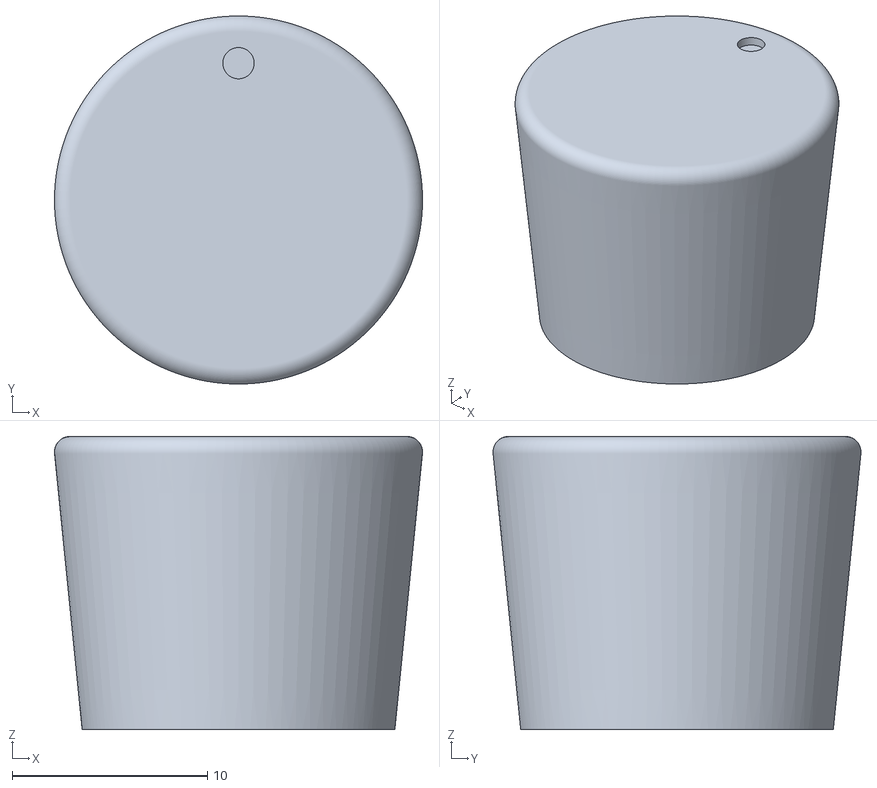
[picture p44: CAD file, 2026-10-19]
cad/out/knob.stl
18.8 x 18.8 x 15.0
