JacobBanghart/clickdeck/cad/out/print_knob_test_stand.stl

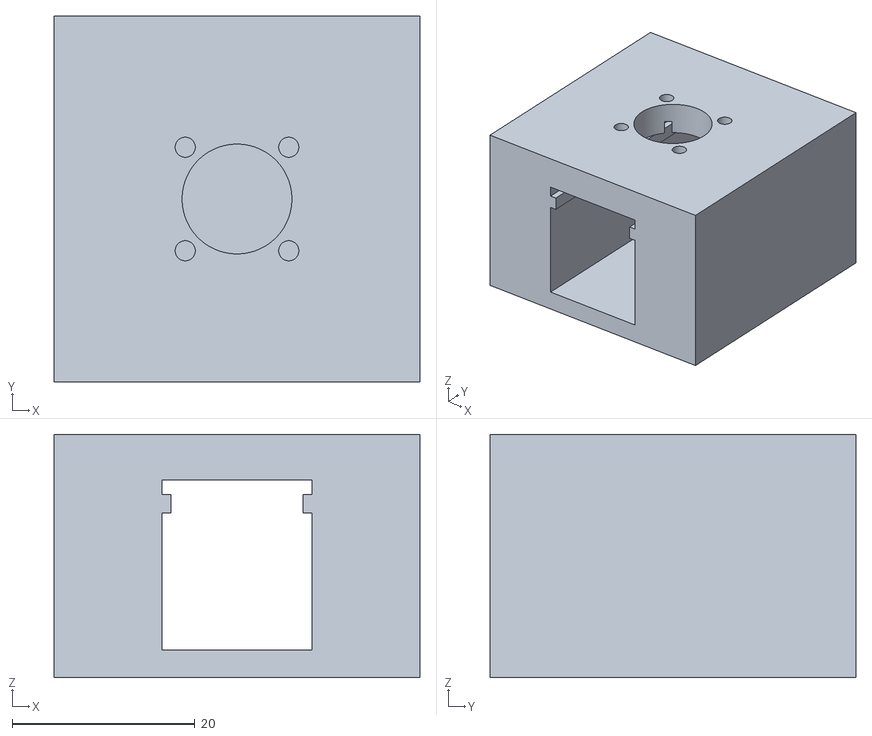
[picture p45: CAD file, 2026-10-19]
cad/out/print_knob_test_stand.stl
40.0 x 40.0 x 26.6
