JacobBanghart/clickdeck/cad/out/key_cap_two_nub_clear_resin.stl

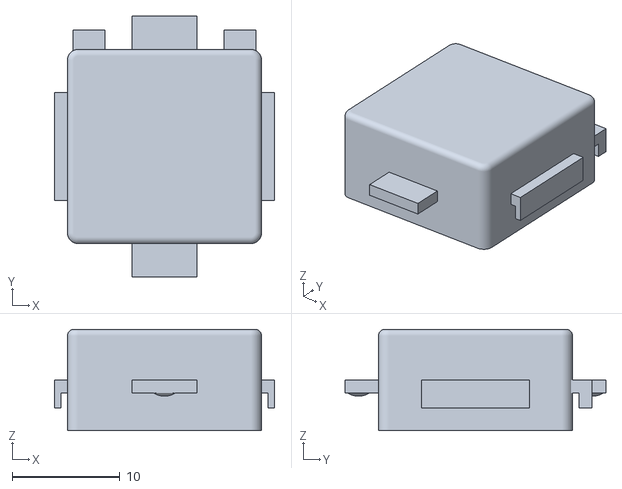
[picture p46: CAD file, 2026-10-18]
cad/out/key_cap_two_nub_clear_resin.stl
20.4 x 24.2 x 9.40
