JacobBanghart/clickdeck/cad/out/print_stand.stl

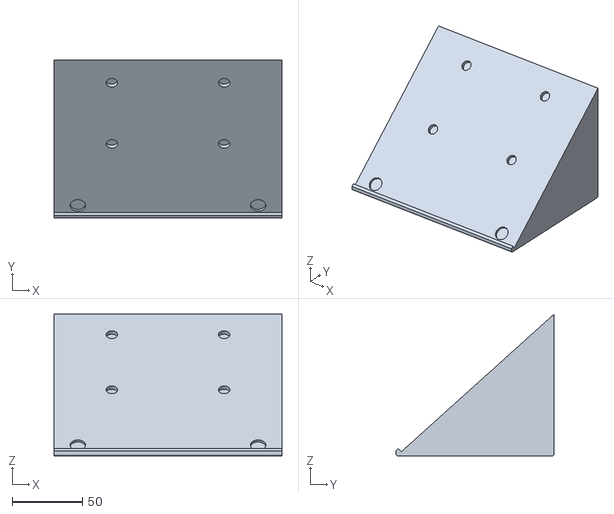
[picture p47: CAD file, 2026-10-18]
cad/out/print_stand.stl
162.4 x 112.8 x 101.0
