JacobBanghart/clickdeck/cad/out/knob_window.stl

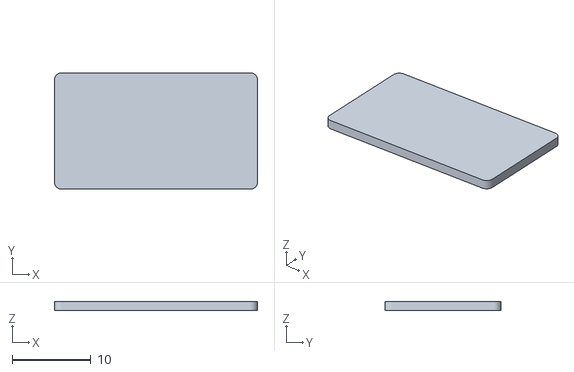
[picture p48: CAD file, 2026-10-17]
cad/out/knob_window.stl
25.8 x 14.8 x 1.20
