JacobBanghart/clickdeck/cad/out/print_plate_prop.stl

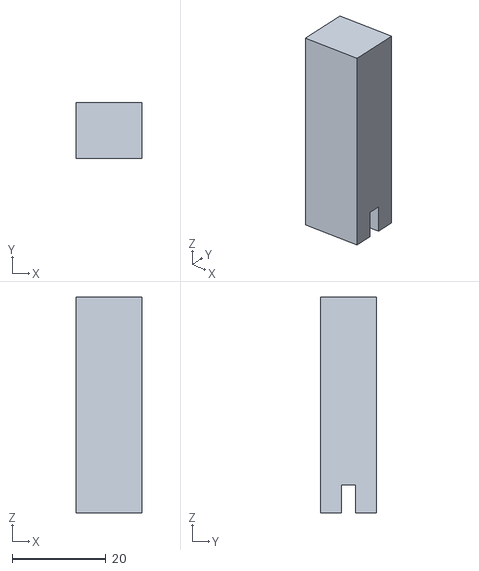
[picture p49: CAD file, 2026-10-17]
cad/out/print_plate_prop.stl
14.0 x 12.0 x 46.0
