JacobBanghart/clickdeck/docs/prototype-tests.md

# Prototype tests (go/no-go)

What the prototype has to show before the full build, and what Rev A (the
full build) checks first. Plan changed 2026-10-18 (D3): the prototype is
a test kit, not custom boards ([parts.md](parts.md)). The **Where** column
says which:
- **Kit:** the 2204 on the printed test stand over an MT6701 breakout,
  driven from the WeAct RP2350B core board by the SparkFun TMC6300
  breakout and by the driver bench board's DRV8311H and SS6343M channels
  (D24); the 7B and the core board behind the CH334F hub module; the two
  keys on the rev C frame PCB on the 7B. These decide go/no-go.
- **Rev A:** needs our own boards: the base with the backplane, 2 haptic
  modules, 1 lite module and blanks (D23). The hinge and press, the slot
  connector and module swaps, the backplane's CC sensing, the connectors
  and cables, the crystal, the pinholes. A failure here
  means one revision of that board (the backplane and each module type are
  separate designs), not a new prototype.
- **Free:** the scrap-FR-4 hinge test, before the Rev A order.

The targets are starting points, not specs. Adjust them once there's
hardware to feel, and record the results here.

Tools: USB power meter between the computer and the board, the calipers, a
phone slow-motion video for timing, a kitchen scale (0.1 g) for press
force, a thermocouple or IR thermometer, and a logic analyzer (a cheap
8-channel one is enough).

## Knob

| Test | Where | How | Pass |
|---|---|---|---|
| Motor on arrival | Kit | Spin each motor by hand, unpowered. Measure phase resistance R, phase-to-stator resistance, thread depth and lead length | At least one motor feels smooth (gate for the JLC order). Phase-to-stator is open |
| Clicky mode | Kit | Set 24 and 48 clicks per turn; turn slowly and fast | Clicks feel distinct and even, none skipped at normal speed |
| Smooth mode | Kit | Zero torque, driver in standby; turn slowly by hand | No noticeable cogging (bumps). If it fails, try the second motor or SparkFun ROB-20441 |
| End stops | Kit | Bounded 0–100; push past each end | Firm stop, springs back, no buzzing; eases off after a few seconds of pushing |
| Current at rest | Kit | Power meter on the driver's 5 V, knob untouched | Driver asleep; ≤ 5 mA above the board's idle current |
| Current while clicking | Kit, then Rev A | Spin through detents: kit, motor current at the 5 V supply; Rev A, on a 1.5 A C-to-C port | Peak motor current ≤ ~0.8 A; VBUS at the meter stays ≥ 4.75 V |
| Default port | Rev A | Same on a 500 mA port and an A-to-C cable | Haptics nearly off (faint detents only), no resets, the configurator shows why |
| Current at an end stop | Kit | Lean on the stop for 30 s | Driver case < 70 °C; the firmware time limit keeps current within the budget |
| Standby back-power | Kit | TMC6300 breakout: `NSTDBY` low, one PWM pin high. Bench board: enable low, one PWM pin high | TMC6300: VIO stays below 0.4 V. DRV8311H and SS6343M: outputs stay off (the motor turns freely), driver current < 0.1 mA |
| Wake latency | Kit | Turn from rest | No dead zone or delay you can feel before the first click |
| Hinge, before ordering | Free (scrap FR-4) | Saw the haptic module's tongue and its two torsion necks into scrap FR-4; load the tongue at the motor axis on the kitchen scale | Record the force for 0.15 mm of travel at the striker; size the necks (or a 1.0 mm module PCB) from it |
| Press feel | Rev A | Kitchen scale under the knob; tune the set-screw striker | Clicks at roughly 150–400 g, one clear click, no rocking |
| Press while turning | Rev A | Turn hard without pressing; push sideways on the knob rim | No accidental press events (if sideways force clicks, plan a parallel-guided flexure) |
| Calibration | Kit | Store, power-cycle 10× | Knob never twitches at power-on; angle and direction stay correct |
| Plug reversed | Kit | Reseat the motor plug the other way, power up | Direction check catches it and recalibrates; the motor never runs away |
| Sensor fault | Kit | Pull the sensor's DO line while the motor holds a detent | Firmware drops `NSTDBY` within one loop |
| Loop timing | Kit | RP2350B running 1 real + 4 dummy FOC loops, 15 PWM outputs, 5 sensor reads | ≥ 2 kHz per motor (aim for 5 kHz) |
| Noise | Kit | Listen up close in a quiet room | No audible whine or buzz at rest or while turning |

### Driver comparison (D24)

The haptic module's driver is the DRV8311H since D24, and nobody is known to
run it with SimpleFOC yet. The driver bench board puts it and the cheaper
SS6343M next to the SparkFun TMC6300 on the same 2204 + MT6701 test stand,
same firmware (`BLDCDriver3PWM`, 3 PWM + enable; the TMC6300 with inverted
low sides), same PWM frequency, 5 V through the USB power meter. Move the
motor plug between them. The DRV8311H has to pass for Rev A; if it doesn't,
the module goes back to the TMC6300 (a module respin). The SS6343M passing
makes it a candidate for a later module revision.

| Test | Where | How | Pass |
|---|---|---|---|
| Runs at all | Kit | Open loop, then closed loop with each driver | SimpleFOC runs closed loop on each; no nFAULT at power-up after the 3 ms wake |
| Smooth-mode current | Kit | Smooth mode (driver asleep, outputs off), knob untouched, then turned by hand | ≤ 5 mA above the board's idle at the meter; no drag you can feel compared with the motor unplugged |
| Detent feel | Kit | 24 and 48 detents, same gains on all three; turn slowly and fast, blind if you can | The DRV8311H feels the same as the TMC6300 (no extra buzz, no softer or uneven clicks) |
| End-stop hold | Kit | Lean on an end stop for 30 s at the firmware's current limit; IR thermometer on the driver | Driver case < 70 °C, and within ~10 °C of the TMC6300 at the same current |
| Brown-out | Kit | Bench supply at 4.75 V into the bench board; detents and end stops | No nFAULT (no undervoltage or overcurrent trip) and no resets |
| Wake | Kit | Turn from rest with the driver asleep | No delay you can feel before the first click (DRV8311H wake: 1–3 ms) |
| Fault line | Kit | Turn the bench supply down through the driver's undervoltage lockout (~2.6 V) and back up | nFAULT goes low and comes back high by itself; firmware logs it and drops the enable |

### Knob modules and slots (D23)

Lite modules have no prototype of their own: an EC11 on a breadboard with
the WeAct RP2350B bench covers the firmware. Slots and modules are first
built on Rev A (2 haptic, 1 lite, blanks).

| Test | Where | How | Pass |
|---|---|---|---|
| Quadrature | Kit (bench) | EC11 on two consecutive GPIOs with the 10 kΩ / 10 nF filter, PIO reader; turn slowly, then spin fast | Every detent counts once, no steps lost or doubled, none while flash is written |
| Press | Kit (bench) | Encoder switch wired as row 4 with a diode, next to held keys | Press reported with keys held; no ghosting |
| Slot detection | Kit (bench), then Rev A | Kit: a diode from a column to ID row A, then B, then none. Rev A: haptic, lite and blank in different slots, power-cycle | `HELLO_ACK` lists each slot right (`haptic` / `lite` / `empty`); the configurator shows knob feel only on haptic slots and hides empty ones |
| Module swap | Rev A | USB unplugged: pull the cap, undo the two screws, lift the module out, drop it back in; 30 times on one slot, then swap slots | Comes out and goes in straight with the case closed; the key pins stop it turned round; every slot still reads right and every knob works after each swap |
| Slot contact | Rev A | Meter each pogo contact through a seated module (pad to backplane net); then turn a haptic knob hard, press it, and push it sideways while logging SSI CRC errors | Every contact < 0.2 Ω; no CRC errors or dropouts while the knob is worked |
| Pins at full current | Rev A | Lean on an end stop on a 3 A port for 30 s | The VMOT pins and pads stay below ~50 °C; no brownout |
| Knob fit | Rev A | Calipers: haptic and lite knob tops, blank and covers against the plate | Knob tops level with each other (±0.2 mm); covers and blanks flush (±0.2 mm); a lite press clicks without touching the cover |
| Default port | Rev A | Only lite modules and blanks: 500 mA port, A-to-C cable, full brightness | No resets, no brownouts |

## Keys

| Test | Where | How | Pass |
|---|---|---|---|
| Rest state | Kit | Assemble one key dry; multimeter across the switch | Open at rest (the stack doesn't pre-press the switch) |
| Gap | Kit | Feeler gauge or calipers: cap bottom to glass | Record it (model: 0.8 mm); must be > 0 under every key |
| Down-stop | Kit | Press each cap at 3 N, then harder, with witness film on the glass | The cap's rails and lugs stop on the frame PCB after ~0.5 mm, past the switch's click; no mark on the film |
| Click feel | Kit | Press each key 50× | Crisp click every time; decide whether 0.15 mm travel feels good or too short |
| Off-center click consistency | Kit | Kitchen scale. Press each cap at the center, each corner and the far edge from the switch. Record the force and the click feel at each point | The far edge needs ≤ 2× the center force, and every press clicks cleanly. If it fails: SLA resin guide inserts (tighter fit, ~0.6° tilt), or the second switch per key (footprints already on the proto frame) |
| Glass load | Kit | Witness film (or carbon paper) on the glass, press 10 N on each cap | No mark on the glass |
| Missed events | Kit | 500 presses per key, logic analyzer on the switch and the USB events | 0 missed or doubled events |
| Rattle | Kit | Shake the prototype; tap keys lightly | No rattle you'd notice in use (if it fails, try a foam or silicone ring on the flange) |
| One switch vs two | Kit | Same off-center click test on a cap with one switch (SW1/SW2, one-nub cap) and one with two (SW3/SW4 wired too, two-nub cap) on the rev C frame PCB | Decides whether the full build uses two switches per key |
| Image | Kit | Look through the cap from straight on and at 45° | Image looks like it's on the key surface; edges and gaps acceptable |
| Down and up events | Kit | Hold a key 3 s | Separate key-down and key-up events (push-to-talk works) |

## Touch band

The band is an optional add-on, off by default (D12, D24), so these run on
the first build that fits one (Rev A doesn't by default): the real band
under the printed top plate, read by its AT42QT2120 (all channels as keys, position
interpolated in firmware), with the motors running next to it and the
panel lit. Guard trace, hatched ground and the 300 ms lockout in place. If
it fails, the band gets one revision with the knobs further forward (D11),
or is dropped. A copper-tape strip on the bench can't show the motor and
panel interference, so the kit skips it.

| Test | Where | How | Pass |
|---|---|---|---|
| Tap | Rev A | Tap each of the knob-display positions 20× | 20/20 detected, no ghost taps |
| Position | Rev A | Tap at marked points along the band | Within ±5% of the band length |
| Latency | Rev A | Slow-motion video of a tap and the host's event | < 50 ms |
| Swipe | Rev A | Swipe left and right along the band | Direction and position tracked smoothly |
| Hand nearby | Rev A | 10 min of normal knob use (turning, pressing, hand resting on the plate) | 0 false touches |

## USB and display

| Test | Where | How | Pass |
|---|---|---|---|
| Image speed | Kit | Send a full page of key images (compressed) | Shows in under 300 ms. Record the raw throughput (plan: ~0.5 MB/s) |
| Flash-write glitch | Kit | On a 7B: full-screen redraws while images stream over USB and the cache is written to flash | No flicker, no lasting image shift |
| Reconnect | Kit | Unplug and replug | Keys reappear without resending images (cache works) |
| Standalone | Kit | Set keys, a macro and knob feel in the configurator; close it; plug into another computer with no software | Keys, macros and knob feel all work; the display shows the stored page; no key stays held |
| Idle | Kit | Leave untouched: with the daemon running, with the GPIO6 link and no host, and with neither | Blanks and wakes on touch, key or knob in the first two cases; never blanks in the third |
| Offline pages | Kit | Link fitted, no host: press a page-switch key | Images, keymap and knob feel all change together |
| Two devices, one hub | Kit, then Rev A | RP2350B (core board, then the backplane) and display (ESP32-S3) behind the CH334F (hub module, then the USB board); replug in a different port | The configurator pairs them every time; images and events land on the right device |
| Browsers and OSes | Kit | Configurator in Chrome and Edge on Linux (with the udev rule), Windows and macOS | Both devices open; no driver installs |
| Power descriptors | Kit | `lsusb -v`, `lsusb -t`, `dmesg` on Linux | Both devices declare ≤ 100 mA; no "insufficient available bus power" |
| Connectors | Rev A | JST-GH link, FFC + ZIF to the frame PCB, JST-SH to the touch strip | All work; footprints and pin 1 match the bought cables |
| Crystal start-up | Rev A | Power-cycle the RP2350B 50× with the basic C9002 crystal and 33 pF caps, at room temperature, cold (from a freezer) and warm (~50 °C) | Boots and enumerates every time. If not, fit the ABM8-272-T3 with 15 pF ([pcb.md](pcb.md)) |

## Firmware stress

| Test | Where | How | Pass |
|---|---|---|---|
| Replug | Kit | Unplug and replug 50× | Enumerates every time; no stuck keys, no lost settings |
| Sleep and resume | Kit | Suspend and wake the PC 10× | Screen blanks and motors sleep in suspend; no stored HID shortcut fires on resume |
| Flash while running | Kit | `SAVE` / `PERSIST` while knobs turn and images stream | No FOC glitch you can feel, no display glitch |
| Brownout | Rev A | Pull VBUS down with a load or a long thin cable | Motors cut, the device stays enumerated, the trip shows in `STATUS` |
| Fuzz | Kit | Send malformed and random frames to both data channels for 10 min | No crash or hang; bad frames get `ERROR` |
| Lock | Kit | Lock off: send a keymap change and a bootloader request to each chip. Lock on: repeat; don't hold, then hold a knob 3 s | Lock off: both apply at once, no button or pinhole. Lock on: nothing changes without the hold; both apply after it. Lock on without the GPIO6 link, the display's bootloader request stays refused (`not-confirmed`) and the configurator asks for the BOOT pinhole |

## Updates and recovery

Steps in [recovery.md](recovery.md).

| Test | Where | How | Pass |
|---|---|---|---|
| Web update | Kit | Update both chips from the configurator 10× | Every update succeeds; settings survive |
| Interrupted update | Kit | Pull the cable halfway through each chip's update | The retry succeeds from the configurator |
| Pinholes | Rev A | Start each chip's bootloader with BOOT (back wall) and BOOTSEL (case floor, slab lifted off the stand); flash from there | Both work with the case closed |
| EXIO5 stuck | Kit | Test firmware drives EXIO5 high; then unplug 10 s | USB is gone until the power-off, then back |
| Settings reset | Kit | Hold the top-left key while plugging in | Defaults back, firmware and knob calibration kept |
| Corrupt settings | Kit | Corrupt the stored settings block (test build) | Boots defaults; the old block is kept until the next save |
| Factory restore | Kit | "Restore factory firmware" in the configurator | Both chips back on the release builds |

## Power and USB bring-up (first full-build boards)

In order; stop at the first failure. "PC unplugged" means exactly that:
the JST-GH contacts aren't staggered.

1. Bare boards: check for shorts between VBUS, 3V3 and GND.
2. Power from a current-limited bench supply (~300 mA) first.
3. CC readings with 0.5 / 1.5 / 3 A sources, in both cable orientations.
4. PC unplugged: check the JST-GH cable pin 1 to pin 1, then plug it in.
5. `lsusb -t`: the hub at 480M, both devices at 12M on separate ports; no
   power rejections in `dmesg`. Repeat on Windows and macOS.
6. Scope VBUS inrush and ringing at hot-plug, with only the 2 × 22 µF
   input ceramics fitted. The peak stays under 6 V; if not, fit the
   polymer cap.
7. PC unplugged: plug in a reversed GH cable, then power up. Nothing gets
   hot; the backplane doesn't enumerate; no damage after the straight
   cable goes back.
8. Electronic-load sweep of each motor budget for 10 min on real laptop
   ports.
9. Short the display port's output: the switch limits, the hub and knob
   board stay up.
10. Stream images while knob HID traffic runs at the same time.
11. Sleep and wake the PC.
12. Pull the external cable sideways and axially, about 30 N; ESD at the
    external port if a gun is available.

## First full build

- Log the case and 7B temperatures for 2 h at full brightness.
- Measure the 7B: `PANEL_T`, the front lip, its current at full
  brightness, and record the board's silkscreen revision. Probe the
  backlight EN/FB while sweeping brightness.

## Decision

- **Go (order Rev A):** the kit's knob feel (clicky, smooth, stops) and
  key click both pass, and current numbers fit the power budget. The press
  feel is judged on Rev A (the hinge test only sizes it).
- **Adjust and retest:** a mechanical part fails (cap, motor, stand) but
  the approach works. Change `params.py`, reorder that part.
- **On Rev A:** a "Rev A" test fails → one revision of that board only
  ([cost.md](cost.md) has the per-board cost).
- **Rethink:** smooth mode cogs with every motor tried, or the key click
  can't be made to feel good.
