JacobBanghart/clickdeck/(commit log)

2026-10-17 Initial plan, parts list, and PCB plan
2026-10-17 Add parametric CAD models (build123d) for full device and prototype
    Full device: 7x3 keys at 22 mm pitch over a 7" panel, 5 haptic knobs with
    display windows. Prototype: 2 keys + 1 knob on a 2.4" screen in a laser-cut
    acrylic sandwich. Exports STEP, DXF (KiCad outlines, laser-cut plates), STL,
    and preview renders. Parts list updated: 2.4" screen, B3U switches.
    [clickdeck_full.step, clickdeck_proto.step, full_frame_pcb_outline.dxf, full_top_plate.dxf, key_cap_clear_resin.stl, key_cutaway.step, knob_cap.stl, proto_base_plate_3mm_acrylic.dxf]
2026-10-17 Angle the case on a wedge stand; Keebio-shaped knobs that bolt to the motor
    - Slab tilts 25° (TILT_DEG) about its front edge on a separate stand, Stream
    Deck + XL style. New side and face-on previews.
    - Knobs copy the Keebio tapered shape and bolt straight onto the motor bell
    (KNOB_STYLE=integrated). keebio_adapter style keeps the option to reuse
    real Keebio knobs on a 6 mm D-shaft adapter.
    [clickdeck_full.step, clickdeck_proto.step, full_frame_pcb_outline.dxf, full_top_plate.dxf, key_cutaway.step, knob.stl, knob_cap.stl, proto_base_plate_3mm_acrylic.dxf]
2026-10-17 Add angle comparison script for picking the case tilt
2026-10-17 Set case tilt to 42°
    [clickdeck_full.step, clickdeck_proto.step, full_frame_pcb_outline.dxf, full_top_plate.dxf, key_cutaway.step, proto_base_plate_3mm_acrylic.dxf, proto_frame_pcb_outline.dxf, proto_top_plate_3mm_acrylic.dxf]
2026-10-17 Cheaper build and parity features: one knob board, press-to-click, touch band
    - Knob board: one PCB for all 5 knobs (RP2350B). Each knob sits on a tongue
    cut free by a U-slot and hinged at the back; pressing flexes it onto a B3U
    switch underneath (press-to-click). Motors driven with 3 PWM each.
    - Touch band: capacitive sensor PCB under the top plate below the knob
    displays (the display glass sits ~7 mm down, too deep to touch). Knobs
    moved forward 4 mm for a 10 mm band.
    - Case parts exported as STLs and checked against a 256 mm print bed.
    - Docs: OpenDeck as the host app, single JLC order with all PCBs in one
    panel, RP2350B pin budget and driver plan, updated costs.
    Co-Authored-By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
    [clickdeck_full.step, clickdeck_proto.step, full_frame_pcb_outline.dxf, full_knob_board_outline.dxf, full_top_plate.dxf, key_cap_clear_resin.stl, key_cutaway.step, knob.stl]
2026-10-17 Add lessons from related projects and fold them into the design
    Researched Stream32, eezbotfun, Open Deck, SimpleFOC and SmartKnob code,
    docs and issues. Design changes: USB power budget for 5 motors, RP2350B
    flashable through the ESP32-S3, stored knob calibration, MT6701 over SSI,
    motor mount for more than one motor, TMC6300 stock check with DRV8316
    fallback, protocol lessons from Stream32.
2026-10-17 Power budget: wake knobs on movement, share one motor's worth of current
2026-10-17 Use Waveshare ESP32-S3-LCD-7B; document free pins; knobs need no Keebio parts
    - Original ESP32-S3-LCD-7 backlight is on/off only (CH422G EXIO2). The 7B
    (1024x600, non-touch SKU 31727, $33.99) adjusts brightness at the same price.
    - Free pins on the board: UART connector GPIO43/44 for the knob-board link,
    sensor connector (likely GPIO6) to reset the knob board. Knob board
    firmware updates over that UART, USB pads + BOOTSEL for recovery.
    - Knobs are printed as part of the build; the optional adapter style takes
    any standard 6 mm D-shaft knob.
    [clickdeck_full.step, clickdeck_proto.step, full_frame_pcb_outline.dxf, full_knob_board_outline.dxf, full_top_plate.dxf, key_cutaway.step, proto_base_plate_3mm_acrylic.dxf, proto_frame_pcb_outline.dxf]
2026-10-17 Add open questions, prototype pass/fail tests, CAD CI; update parts list
    - docs/open-questions.md: everything unverified, with how/when it's answered
    - docs/prototype-tests.md: measurable go/no-go criteria for the prototype
    - Parts list: USB power meter and 0.1 g scale for the tests; totals updated
    - CI: rebuild CAD with a pinned toolchain, fail on fit warnings or stale
    outputs. Impossible layouts now warn instead of crashing.
    [build.py]
2026-10-17 Model the real Waveshare ESP32-S3-LCD-7B from its drawing and schematic
    - Panel: 165.72 x 97.6 frame, 153.84 x 85.632 active area, off-center
    borders; mounted on posts under its 4 M3 tabs, thick border toward the
    knobs so Waveshare's board sits at the back.
    - Waveshare's board modeled behind the panel; checks clearance to the knob
    board (8 mm) and the floor (1.3 mm, estimated heights).
    - USB-C: plug tunnel through the left wall to the board's native port.
    - New inside_layout.png render.
    [clickdeck_full.step, clickdeck_proto.step, full_frame_pcb_outline.dxf, full_knob_board_outline.dxf, full_top_plate.dxf, key_cutaway.step, print_case_tray.stl, print_stand.stl]
2026-10-17 Generate the prototype frame PCB from the CAD; wiring and power spec
    - hardware/proto-frame: KiCad board built from cad/out/proto_frame_pcb.json
    (2x B3U, wire pads, M2 holes), DRC clean, JLC Gerbers/BOM/CPL, renders.
    - Frame PCB hangs from the top plate on M2 standoffs (holes in both).
    - docs/wiring.md: power path via the 7B's J9, default 500 mA motor budget
    (the 7B can't read USB-C current), soft start, brownout guard, connector
    pinouts from Waveshare's schematic, knob presses in the key matrix,
    RP2350B pin budget (44/48).
    - Open questions: GPIO6 and USB-C current answered; B3U NRND and 7B
    thickness added.
    [clickdeck_full.step, clickdeck_proto.step, full_frame_pcb_outline.dxf, full_knob_board_outline.dxf, full_top_plate.dxf, key_cutaway.step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]
2026-10-17 Rev 0 knob module spec and USB protocol draft
    - docs/knob-module.md: netlist, parts with LCSC numbers, design notes.
    TMC6300 datasheet confirms built-in break-before-make (3-PWM plan A is
    safe); the inverter is powered from the standby pin so a sleeping driver
    never sees a high input.
    - docs/protocol.md: composite USB (HID fallback + data channel), binary
    framing, versioned handshake with features, image cache by CRC, overlays,
    key down/up, knob config and haptics, power, firmware updates, internal
    UART link.
2026-10-17 Add tipping/stability estimate to the CAD checks; refresh renders and README status
    Estimated 940 g; tipping backward takes ~10 N on a top-row key vs ~3 N for
    a firm press. Build warns below a 2x margin.
    [clickdeck_full.step, clickdeck_proto.step, full_frame_pcb_outline.dxf, full_knob_board_outline.dxf, full_top_plate.dxf, key_cutaway.step, proto_base_plate_3mm_acrylic.dxf, proto_frame_pcb_outline.dxf]
2026-10-17 Check the risks: 7B depths from Waveshare's STEP model, TMC6300 stock/price, B3U alternatives
    - 7B: panel 6.2 mm, board flat on the frame, connector row 16.1 mm below the
    glass. Model updated; connector row gets a 1 mm floor pocket.
    - TMC6300-LA out of stock; TMC6300-LA-T (C5274455) 200 in stock at $5.93.
    Knob board cost corrected ($105-130 with JLC's 2-board minimum); build
    totals updated, now about the same as or more than a Stream Deck + XL.
    - B3U: still in production per Octopart; same-size alternatives listed.
    [clickdeck_full.step, clickdeck_proto.step, full_frame_pcb_outline.dxf, full_knob_board_outline.dxf, full_top_plate.dxf, key_cutaway.step, print_case_tray.stl, proto_base_plate_3mm_acrylic.dxf]
2026-10-17 Mounting hardware, assembly/service guide with pictures and animation, buildability checks
    - Model: posts and bosses printed with the tray and top plate (they were
    missing from the tray print file), self-tapping screws with recorded
    directions, removable knob caps on hubs, magnets for the stand, rubber
    feet, BOOT/RESET pinholes, cable runs, 3 mm floor for recessed heads.
    - Fixed: knob board poked into the front wall; frame PCB screws only where
    no glass is under the head.
    - cad/assembly.py: 8 assembly steps; checks for part interference,
    screwdriver access per step (19/19), service lift-out order, and pinhole
    reach. First run found 28 problems (post clearances, magnets on screws,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
    [clickdeck_full.step, clickdeck_proto.step, full_frame_pcb_outline.dxf, full_knob_board_outline.dxf, full_top_plate.dxf, key_cutaway.step, knob.stl, print_case_tray.stl]
2026-10-17 CAD: internal USB hub and plug-in cabling, with plug/cable checks
    - USB board (hub, external USB-C) in the back-left corner with an arm to a
    back-wall port 16 mm left of center (center has the BOOT/RESET pinholes).
    Mid-mount socket flush with the inside of the wall; the plug overmold
    seats in a 14 x 8 mm opening; printed backstop and 4 M2 screws.
    - Removed the left-wall USB-C tunnel and the HY2.0 link bundle.
    - Display board's two USB-C ports placed from Waveshare's STEP model.
    - Full-size plug bodies for every mated connector (USB-C overmolds, JST-GH,
    JST-SH, FFC ends, 3-pin motor plugs) so the interference check sees them.
    - Cables routed with filleted paths; bends below the minimu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
    [clickdeck_full.step, clickdeck_proto.step, full_frame_pcb_outline.dxf, full_knob_board_outline.dxf, full_top_plate.dxf, full_usb_board_outline.dxf, key_cutaway.step, print_case_tray.stl]
2026-10-17 Docs: internal USB hub, plug-in cables, strain relief, BOM
    - wiring.md rewritten: hub architecture and where the USB board goes (options
    compared), power path, reading the port's current offer via CC, connector
    table, pinouts, cable lengths, strain and service section, pin budget.
    - plan.md, protocol.md: two USB devices behind a hub, host pairing, RP2350B
    updates over its own USB (UF2), no internal UART link.
    - pcb.md: USB board added; one-panel thickness note for the touch band.
    - open-questions.md: UART bootloader and USB-C current questions resolved;
    new risks (hub stock, motor plug/lead, plug sizes, offline page switching).
    - cost.md, README: USB board and ready-made cables (+~$2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
2026-10-17 Add 17 independent design reviews and the combined design review
    Eight components (keys, knobs, display, touch, enclosure, power/USB,
    firmware, sourcing) each got a senior and an adversarial review, plus a
    short-circuit and rail-spacing review. docs/design-review.md merges them
    into 86 findings (67 fixes, 19 decisions), resolves disagreements from
    primary sources, and records the owner's answers to D1-D18.
2026-10-17 Apply the design review's no-decision fixes
    CAD: knob hub flange with D-flat and crush-rib cap, motor spacer and
    screws, panel/plate screw engagement check, display dims from Waveshare's
    STEP, USB socket board margin, hub next to the external socket, knob
    window ledge + STL + BOM, stand lip and foot pockets, tilted-assembly,
    gap and floating checks, proto frame screws and pads off the glass (rev B).
    Docs: TMC6300 BRUV/BRW, MT6701CT SOP-8, mirror-safe JST-GH pinout,
    CH334F crystal and bMaxPower, reverse-blocking switches and knob-feed
    limit, RGB panel flash-write mitigation, protocol framing/CRC/PING,
    touch band guard and lockout, measurable prototype tests.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
    [clickdeck_full.step, clickdeck_proto.step, full_frame_pcb_outline.dxf, full_knob_board_outline.dxf, full_top_plate.dxf, full_touch_band_outline.dxf, full_usb_board_outline.dxf, key_cap_clear_resin.stl]
2026-10-18 Apply the owner's design decisions (D1-D18) and the recovery plan
    Key support: 0.8 mm cap/frame gap, cap down-stop at 0.5 mm, 14 frame
    screws (9 countersunk over the glass), keystack.py drop + flex check.
    Knob board top-side only: press switch on the fixed front border with
    a striker arm on the motor spacer; drivers off the tongue.
    Prototype widened: real 7B, proto frame rev C with second-switch
    footprints, full-length touch band, Rev 0.5 test board outline.
    Heat-set M3 inserts, PETG; optional GPIO6 link and PD sink footprints;
    BOOTSEL pinhole in the floor; touch band optional (TOUCH_BAR flag).
    Docs: VIA-style web configurator (configurator.md) with an optional
    daemon, ROM-bootloader update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
    [clickdeck_full.step, clickdeck_proto.step, full_frame_pcb_outline.dxf, full_knob_board_outline.dxf, full_top_plate.dxf, full_touch_band_outline.dxf, full_usb_board_outline.dxf, key_cap_clear_resin.stl]
2026-10-18 Cost breakdown with researched JLC fees; VIA-style trust for flashing
    cost.md: where-the-money-goes table (JLC boards 43%, duty 24%), 24
    extended part types counted against JLC's library, Economic vs Standard
    PCBA fees, Global Sourcing and duty details, levers that don't cut
    features. Single build now ~$475-735 (own printer). BOM generator:
    price on every line, LCSC numbers, stock warnings, current totals.
    D17 changed: Chrome's device picker is the confirmation (like VIA);
    everything flashes from the web configurator with no pinhole. An
    optional on-device lock brings back the 3 s knob hold.
2026-10-18 Add sourcing-options.md: PCB/PCBA routes compared for one build and a group buy
2026-10-19 Cheaper in-stock part swaps, ENIG, panel-area check
    19 extended part types (was 24): basic C9002 crystal, SRV05-4-P-T7 ESD
    (preferred), one TPS259470 eFuse for all three switches, basic input
    caps and AMS1117 regulator, in-stock HC-GH-8PWT header. ENIG finish.
    build.py reports the JLC panel area against the 650 cm2 large-size fee
    (accepted pending a real quote). Group buy deferred until a device works.
    [clickdeck_full.step, clickdeck_proto.step, full_frame_pcb_outline.dxf, full_knob_board_outline.dxf, full_top_plate.dxf, full_touch_band_outline.dxf, full_usb_board_outline.dxf, key_cutaway.step]
2026-10-19 Prototype becomes a small test kit; the full build is Rev A
    Final parts bought early and reused (7B, 6 motors, magnets). Throwaway
    kit: SparkFun TMC6300 + MT6701 breakout on a printed knob test stand for
    knob feel, rev C 2-key frame on the 7B for key click, WeAct RP2350B and
    hub module as the firmware bench. Rev 0 knob module and Rev 0.5 board
    dropped; their circuits are tested on Rev A, with single-board respins
    costed per board. Prototype CAD and BOM updated.
    [clickdeck_full.step, clickdeck_proto.step, full_frame_pcb_outline.dxf, full_knob_board_outline.dxf, full_top_plate.dxf, full_touch_band_outline.dxf, full_usb_board_outline.dxf, key_cutaway.step]
2026-10-19 Lock design constraints: guided caps, one shared display, optional attention haptics, own look
    Keys: caps travel straight, guided by a skirt under each plate hole; no
    rocker, hinged or pivoting caps (D8 option 4 = second switch only). New
    key-stack check fails if guided tilt lets the cap edge reach the glass.
    Prototype top plate is now printed so it can carry the guides.
    Displays: all key and knob images come from the single shared 7B panel.
    Haptics: core knob feel first; attention nudges/notifications become an
    optional module, off by default, not in the v0 protocol.
    Look: CAD comments describe the slab and wedge stand neutrally.
    [clickdeck_full.step, clickdeck_proto.step, full_frame_pcb_outline.dxf, full_knob_board_outline.dxf, full_top_plate.dxf, full_touch_band_outline.dxf, full_usb_board_outline.dxf, key_cutaway.step]
2026-10-19 Cap guide: realistic 0.05 mm fit; down-stop keeps caps off the glass
    Guide clearance 0.05 mm per side (tuned with the fit coupon). The tilt
    is guide slop; the key-stack check now counts guide tilt plus the
    down-stop with the switch bottomed (worst drop 0.51 mm, 0.29 mm to the
    glass on the full build), checks every key's guide on all four sides,
    and still checks stop feet land on the PCB. Off-center click test with
    resin inserts or a second switch as the fallback.
    [clickdeck_full.step, clickdeck_proto.step, full_top_plate.dxf, key_cutaway.step, print_fit_coupon.stl, print_proto_top_plate.stl, print_top_plate.stl]
2026-10-19 Add a lite knob tier (D22): push encoders, no motors
    A second, cheaper knob board with five Bourns PEC11R push encoders
    (detented PEC11R-4215F-S0024 or smooth PEC11R-4015F-S0024, chosen when
    ordering). Same outline, holes, connectors and RP2350B as the haptic
    board; everything else in the device is shared. The display stays the 7B.
    - params: KNOB_TIER, encoder dimensions, lite knob stem
    - model: lite knob board (no tongues or motor holes), encoders, knob cap
    with a stem that seats on the shaft tip at the haptic knob's height
    - build.py: builds both tiers; lite STEP, outline, knob STL, preview and
    a summary section; lite fit warnings fail --strict
    - assembly.py --check: lite checks near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
    [clickdeck_full.step, clickdeck_full_lite.step, clickdeck_proto.step, full_frame_pcb_outline.dxf, full_knob_board_lite_outline.dxf, full_knob_board_outline.dxf, full_top_plate.dxf, full_touch_band_outline.dxf]
2026-10-19 Knob modules in slots (D23): backplane, haptic/lite modules, blanks
    Knobs become modules. The case keeps its five knob positions as slots;
    each takes a haptic module, a lite module (D22's push encoder, now a
    module type) or a blank, swapped from the top with the case closed.
    - Backplane replaces the knob board (same place, outline and
    connectors): RP2350B runs every slot; modules have no MCU
    - Slot connector: 18 SMD pogo pins per slot on the backplane
    (BWCD-L3W2.0H1.0, C2988082) onto ENIG pads under the module, so every
    board stays top-side only (D6). Pinout and GPIO budget (46 of 48) in
    wiring.md; module ID from two key-matrix rows
    - Modules: printed base (sets the pins' working he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
    [blank_cover.stl, clickdeck_full.step, clickdeck_full_lite.step, clickdeck_proto.step, full_backplane_outline.dxf, full_frame_pcb_outline.dxf, full_knob_board_outline.dxf, full_top_plate.dxf]
2026-10-19 D24: cost target $250 at 100 units; DRV8311H driver, touch band off by default
    - Haptic module: DRV8311H (C5218862) in 3x PWM mode replaces the TMC6300 and
    its inverter (PWM_U/V/W -> INHA/B/C; NSTDBY -> nSLEEP + INLA/B/C; MODE and
    SLEW to AVDD, GAIN to AGND; nFAULT on the reserved slot contact C6,
    wired-OR). TMC6300 kept as the fallback (module respin).
    - Driver bench board for the test kit (hardware/driver-bench): DRV8311H and
    SS6343M channels, generated and routed by script, DRC clean.
    - TOUCH_BAR = False by default: band, chip and cable leave the model and
    BOM; backplane SH header is a DNP footprint. CI checks the band option in
    a second job (CLICKDECK_TOUCH_BAR=1, assembly.py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
    [clickdeck_full.step, clickdeck_proto.step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]
